pravrilgreen/iphone-hid/docs/README.md

# Documentation

## Guides

| Document | For |
|---|---|
| [Install a box](guide/install.md) | Parts, wiring, the board image and its HDMI input, installing, `ihcd doctor`, troubleshooting |
| [iPhone setup](guide/iphone-setup.md) | One-time settings on each iPhone |
| [Hardware check](guide/hardware-check.md) | Every touch and button tried on the real phone |

## Development

| Document | For |
|---|---|
| [API](dev/api.md) | REST actions, screen stream and live control protocols, Python SDK |
| [Architecture](dev/architecture.md) | Touch engine, USB gadget, video, server, doctor, simulated iPhone |
| [ADR 0001: languages](dev/adr/0001-languages.md) | Languages across the product |
| [ADR 0002: the box in Go](dev/adr/0002-box-in-go.md) | Why the box software is one Go binary |

## Research

| Document | For |
|---|---|
| [Absolute pointer on iPhone](research/absolute-pointer.md) | How iOS handles an absolute pointer over USB |
| [Custom box design](research/custom-box.md) | The purpose-built box: feasibility, chips, latency, cost, plan, shopping list |
| [Box v1 schematic](../hardware/box-v1/README.md) | Pin-level circuit of the purpose-built box, KiCad project, draft layout and BOM |
| [Ordering box v1](../hardware/box-v1/ORDERING.md) | What to send a layout and assembly house to have the box made |
| [Market survey](research/china-market.md) | How iPhone-control hardware on the market works |
