pravrilgreen/iphone-hid/hardware/box-v1/bom.csv

reference | qty | value | manufacturer | mpn | lcsc | lcsc_confidence | lcsc_evidence | jlc_type | assembly | dnp | unit_price_usd_est | price_basis | footprint | confidence | notes
C101 | 1 | 47uF 35V | KNSCHA | RVT47UF35V67RV0039 | C2836440 | Likely | search excerpt 2026-09-26 | Extended (assumed) | SMT | no | 0.0190 | search excerpt 2026-09-26 | Capacitor_SMD:CP_Elec_6.3x7.7 | Confirmed | VIN bulk capacitor, damps ringing when a long cable is hot-plugged; aluminium electrolytic 47 µF 35 V ±20 %, 6.3x7.7 mm
C102 C404 | 2 | 1uF 50V | Samsung Electro-Mechanics | CL10A105KB8NNNC | C15849 | Likely | JLCPCB parts list snapshot 2026-04-02 | Basic | SMT | no | 0.0110 | JLCPCB parts list snapshot 2026-04-02 | Capacitor_SMD:C_0603_1608Metric | Confirmed | CH224K VDD capacitor; PC-side VBUS capacitor (UFP ≤ 10 µF); 50 V X5R 0603
C103 C104 C111 C112 | 4 | 10uF 50V X7R | Samsung Electro-Mechanics | CL31B106KBHNNNE | C89632 | Likely | search excerpt 2026-09-26 | Extended (assumed) | SMT | no | 0.0556 | search excerpt 2026-09-26 | Capacitor_SMD:C_1206_3216Metric | Confirmed | U102 input capacitor; U103 input capacitor; 50 V X7R 1206 (price: LCSC 100+ break)
C105 C113 | 2 | 100nF 50V | YAGEO | CC0603KRX7R9BB104 | C14663 | Likely | JLCPCB parts list snapshot 2026-04-02 | Basic | SMT | no | 0.0060 | JLCPCB parts list snapshot 2026-04-02 | Capacitor_SMD:C_0603_1608Metric | Confirmed | High-frequency capacitor at the U102 VIN/GND pins; High-frequency capacitor at the U103 VIN/GND pins; 50 V X7R 0603
C106 C114 C309 | 3 | 1uF 25V | Samsung Electro-Mechanics | CL05A105KA5NQNC | C52923 | Likely | JLCPCB parts list snapshot 2026-04-02 | Basic | SMT | no | 0.0070 | JLCPCB parts list snapshot 2026-04-02 | Capacitor_SMD:C_0402_1005Metric | Confirmed | U102 internal LDO capacitor; U103 internal LDO capacitor; Extra VDDA capacitor for the ADC; 25 V X5R 0402
C107 C115 C120 C124 C125 C129 C203 C204 C205 C206 C207 C208 C209 C210 C211 C215 C218 C303 C304 C305 C306 C307 C308 C311 C402 C403 C405 | 27 | 100nF 16V / 100nF | Samsung Electro-Mechanics | CL05B104KO5NNNC | C1525 | Likely | JLCPCB parts list snapshot 2026-04-02 | Basic | SMT | no | 0.0050 | JLCPCB parts list snapshot 2026-04-02 | Capacitor_SMD:C_0402_1005Metric | Confirmed | U102 bootstrap capacitor; U103 bootstrap capacitor; U104 high-frequency input capacitor; U105 high-frequency input capacitor; …; 16 V X7R 0402
C108 C109 C110 C116 C117 C118 | 6 | 22uF 25V X5R | Samsung Electro-Mechanics | CL31A226KAHNNNE | C12891 | Likely | JLCPCB parts list snapshot 2026-04-02 | Basic | SMT | no | 0.0560 | JLCPCB parts list snapshot 2026-04-02 | Capacitor_SMD:C_1206_3216Metric | Confirmed | U102 output capacitor; U103 output capacitor; 25 V X5R 1206
C119 C123 C212 C213 C214 C310 | 6 | 10uF 10V | Samsung Electro-Mechanics | CL10A106KP8NNNC | C19702 | Likely | JLCPCB parts list snapshot 2026-04-02 | Basic | SMT | no | 0.0110 | JLCPCB parts list snapshot 2026-04-02 | Capacitor_SMD:C_0603_1608Metric | Confirmed | U104 input capacitor; U105 input capacitor; 1V2 bulk capacitor at the LT7911D; 1V2_LT_A bulk capacitor; 3V3_LT bulk capacitor; 3V3 bulk capacitor at the MCU; 10 V X5R 0603
C121 C122 C126 C127 C401 | 5 | 22uF 25V X5R | Samsung Electro-Mechanics | CL21A226MAQNNNE | C45783 | Likely | JLCPCB parts list snapshot 2026-04-02 | Basic | SMT | no | 0.0330 | JLCPCB parts list snapshot 2026-04-02 | Capacitor_SMD:C_0805_2012Metric | Confirmed | U104 output capacitor; U105 output capacitor; VCC5V0_SYS bulk capacitor next to the module; 25 V X5R 0805
C128 | 1 | 47nF 50V | Samsung Electro-Mechanics | CL10B473KB8NNNC | C1622 | Likely | JLCPCB parts list snapshot 2026-04-02 | Basic | SMT | no | 0.0080 | JLCPCB parts list snapshot 2026-04-02 | Capacitor_SMD:C_0603_1608Metric | Confirmed | Soft start (~0.5 ms), limits the charging current into the iPhone; 50 V X7R 0603
C130 C312 C313 | 3 | 1nF | FH (Guangdong Fenghua) | 0402B102K500NT | C1523 | Likely | JLCPCB parts list snapshot 2026-04-02 | Basic | SMT | no | 0.0050 | JLCPCB parts list snapshot 2026-04-02 | Capacitor_SMD:C_0402_1005Metric | Confirmed | U106 output filter before the ADC; CC1 ADC filter; CC2 ADC filter; 50 V X7R 0402
C201 C202 | 2 | 18pF C0G | FH (Guangdong Fenghua) | 0402CG180J500NT | C1549 | Likely | JLCPCB parts list snapshot 2026-04-02 | Basic | SMT | no | 0.0040 | JLCPCB parts list snapshot 2026-04-02 | Capacitor_SMD:C_0402_1005Metric | Unknown | [Unknown] Crystal load capacitor (unclear, per the Lontium reference design); Crystal load capacitor; 50 V C0G ±5 % 0402
C216 C217 | 2 | 100nF | Samsung Electro-Mechanics | CL05B104KO5NNNC | C1525 | Likely | JLCPCB parts list snapshot 2026-04-02 | Basic | SMT | no | 0.0050 | JLCPCB parts list snapshot 2026-04-02 | Capacitor_SMD:C_0402_1005Metric | Unknown | [Unknown] AUX AC capacitor (direction/bias unclear, per the Lontium reference design); AUX AC capacitor; 16 V X7R 0402
C219 | 1 | 10uF 25V | Samsung Electro-Mechanics | CL21A106KAYNNNE | C15850 | Likely | JLCPCB parts list snapshot 2026-04-02 | Basic | SMT | no | 0.0230 | JLCPCB parts list snapshot 2026-04-02 | Capacitor_SMD:C_0805_2012Metric | Confirmed | iPhone-side VBUS capacitor (Type-C source ≤ 120 µF); 25 V X5R 0805
C220 | 1 | 100nF 50V | Samsung Electro-Mechanics | CL05B104KB54PNC | C307331 | Likely | JLCPCB parts list snapshot 2026-04-02 | Basic | SMT | no | 0.0070 | JLCPCB parts list snapshot 2026-04-02 | Capacitor_SMD:C_0402_1005Metric | Confirmed | iPhone VBUS high-frequency capacitor; 50 V X7R 0402
C301 C302 | 2 | 18pF C0G | FH (Guangdong Fenghua) | 0402CG180J500NT | C1549 | Likely | JLCPCB parts list snapshot 2026-04-02 | Basic | SMT | no | 0.0040 | JLCPCB parts list snapshot 2026-04-02 | Capacitor_SMD:C_0402_1005Metric | Confirmed | HSE load capacitor: 2 x (12 pF - ~3 pF stray); HSE load capacitor; 50 V C0G ±5 % 0402
C314 C406 C407 C409 | 4 | 10nF / 10nF 50V | Samsung Electro-Mechanics | CL05B103KB5NNNC | C15195 | Likely | JLCPCB parts list snapshot 2026-04-02 | Basic | SMT | no | 0.0050 | JLCPCB parts list snapshot 2026-04-02 | Capacitor_SMD:C_0402_1005Metric | Confirmed | VBUS ADC filter; TX centre-tap capacitor (voltage-mode PHY); RX centre-tap capacitor; VIN ADC filter; 50 V X7R 0402
C408 | 1 | 1nF 2kV X7R | FH (Guangdong Fenghua) | 1206B102K202NT | C9196 | Likely | JLCPCB parts list snapshot 2026-04-02 | Basic | SMT | no | 0.0120 | JLCPCB parts list snapshot 2026-04-02 | Capacitor_SMD:C_1206_3216Metric | Confirmed | Bob-Smith node capacitor (2 kV keeps the 1500 V isolation of the magnetics); 2 kV X7R 1206
C410 | 1 | 1nF C0G | Murata | GRM1555C1H102JA01D | C76947 | Likely | search excerpt 2026-09-26 | Extended (assumed) | SMT | no | 0.0100 | allowance (no price found) | Capacitor_SMD:C_0402_1005Metric | Confirmed | RECOVERY key filter; 50 V C0G 0402
D101 | 1 | SMBJ20A | hongjiacheng | SMBJ20A | C19077575 | Likely | JLCPCB parts list snapshot 2026-04-02 | Preferred | SMT | no | 0.0350 | JLCPCB parts list snapshot 2026-04-02 | Diode_SMD:D_SMB | Confirmed | TVS on VIN: 20 V standoff, 32.4 V clamp, below the 36 V input rating of the LMR33630; 600 W TVS, 20 V standoff, 32.4 V clamp at 18.5 A, SMB
D102 | 1 | BZT52C10 | Diodes Incorporated | BZT52C10-7-F | C155227 | Likely | search excerpt 2026-09-26 | Extended (assumed) | SMT | no | 0.0200 | allowance (no price found) | Diode_SMD:D_SOD-123 | Confirmed | 10 V zener clamping Vgs in Option B (VIN up to 20 V); 10 V 500 mW zener SOD-123
D104 | 1 | SS34 | MDD (Microdiode Electronics) | SS34 | C8678 | Likely | JLCPCB parts list snapshot 2026-04-02 | Basic | SMT | no | 0.0310 | JLCPCB parts list snapshot 2026-04-02 | Diode_SMD:D_SMA | Confirmed | 3 A 40 V Schottky: PC_VBUS -> 5V_SYS (development mode); 3 A 40 V Schottky SMA
D201 D401 | 2 | SMF6.0A | Littelfuse | SMF6.0A | C207260 | Likely | search excerpt 2026-09-26 | Extended (assumed) | SMT | no | 0.0500 | allowance (no price found) | Diode_SMD:D_SOD-123F | Confirmed | iPhone VBUS TVS (Option B with VIN up to 20 V: change to SMF22A); PC VBUS TVS; 200 W unidirectional TVS, 6 V standoff, SOD-123FL
D501 | 1 | RED | Hubei KENTO Elec | KT-0603R | C2286 | Likely | JLCPCB parts list snapshot 2026-04-02 | Basic | SMT | no | 0.0090 | JLCPCB parts list snapshot 2026-04-02 | LED_SMD:LED_0603_1608Metric | Confirmed | RED status LED (red: no iPhone, yellow: HID but no video, green: ready); red 615-630 nm, Vf 1.8-2.4 V @ 20 mA
D502 | 1 | YELLOW | Foshan NationStar | NCD0603Y2 | C89811 | Likely | JLCPCB parts list snapshot 2026-04-02 | Preferred | SMT | no | 0.0210 | JLCPCB parts list snapshot 2026-04-02 | LED_SMD:LED_0603_1608Metric | Confirmed | YELLOW status LED (red: no iPhone, yellow: HID but no video, green: ready); yellow 586-595 nm, Vf 1.6-2.6 V
D503 | 1 | GREEN | Hubei KENTO Elec | KT-0603YG | C2289 | Likely | search excerpt 2026-09-26 | Extended (assumed) | SMT | no | 0.0059 | search excerpt 2026-09-26 | LED_SMD:LED_0603_1608Metric | Confirmed | GREEN status LED (red: no iPhone, yellow: HID but no video, green: ready); yellow-green (AlInGaP class) 0603; confirm Vf on the datasheet
F101 | 1 | 5A 32V | Littelfuse | 0466005.NRHF | C57525 | Likely | search excerpt 2026-09-26 | Extended (assumed) | SMT | no | 0.0326 | search excerpt 2026-09-26 | Fuse:Fuse_1206_3216Metric | Likely | [Likely] Very fast 5 A / 32 V input fuse; 466 series very fast acting 5 A 32 V 1206 (halogen-free version of 0466005.NR)
FB201 FB202 FB301 | 3 | 600R@100MHz | Murata | BLM18KG601SN1D | C85833 | Likely | search excerpt 2026-09-26 | Extended (assumed) | SMT | no | 0.0110 | search excerpt 2026-09-26 | Inductor_SMD:L_0603_1608Metric | Confirmed | Ferrite bead isolating the LT7911D 3.3 V; Ferrite bead isolating the 1.2 V analog/PLL supply; Ferrite isolating VDDA (VDDA = VIO at DC); 600 Ω @ 100 MHz, 1.3 A, 0.15 Ω, 0603
J101 J401 | 2 | USB-C PD IN / USB-C PC | Korean Hroparts Elec | TYPE-C-31-M-12 | C165948 | Likely | search excerpt 2026-09-26 | Extended (assumed) | SMT | no | 0.0960 | search excerpt 2026-09-26 | Connector_USB:USB_C_Receptacle_HRO_TYPE-C-31-M-12 | Confirmed | USB-C port that takes PD power from the charger (power + CC only); USB-C to the PC: the box is a USB device (UVC + USB network + control); USB-C 16P USB 2.0 receptacle, SMD, 5 A
J201 | 1 | USB-C iPhone | Korean Hroparts Elec | TYPE-C-31-M-04 | C129018 | Likely | search excerpt 2026-09-26 | Extended (assumed) | SMT | no | 0.3594 | search excerpt 2026-09-26 | box-v1:USB_C_Receptacle_HRO_TYPE-C-31-M-04 | Confirmed | 24-pin USB-C receptacle with all SS pairs (4-lane DP Alt Mode) + USB 2.0 + CC + VBUS; USB-C 24P USB 3.1 receptacle, hybrid (A row SMD, B row through-hole); replaces the Molex 105450-0101 of the first draft, whose all-SMD B row sits behind a keep-out and cannot be escaped without via-in-pad
J402 | 1 | RJ45 10/100 | HANRUN (Zhongshan HanRun Elec) | HR911105A | C12074 | Likely | search excerpt 2026-09-26 | Extended (assumed) | THT (hand or selective solder) | no | 0.9082 | search excerpt 2026-09-26 | Connector_RJ:RJ45_Hanrun_HR911105A_Horizontal | Confirmed | RJ45 with magnetics (magjack) 10/100; RJ45 with 10/100 magnetics and LEDs, through-hole
J501 | 1 | MCU SWD+UART | Würth Elektronik | 61300711121 |  |  |  | Extended (assumed) | THT (hand or selective solder) | no | 0.1000 | allowance (no price found) | Connector_PinHeader_2.54mm:PinHeader_1x07_P2.54mm_Vertical | Confirmed | WCH-LinkE header for the CH32V305 (2-wire SWD + debug UART); WR-PHD 2.54 mm 1x7 straight; any 2.54 mm 1x7 header fits; LCSC code: choose at order
J502 J503 | 2 | MCU USB FS / SoC UART | Würth Elektronik | 61300311121 |  |  |  | Extended (assumed) | THT (hand or selective solder) | no | 0.0500 | allowance (no price found) | Connector_PinHeader_2.54mm:PinHeader_1x03_P2.54mm_Vertical | Confirmed | Second (Full-Speed) USB of the CH32V305 (ISP over USB, experiments); RV1106 console (UART2_M1, 115200 8N1, 3.3 V); WR-PHD 2.54 mm 1x3 straight; any 2.54 mm 1x3 header fits; LCSC code: choose at order
L101 L102 | 2 | 10uH | Bourns | SRP1038A-100M | C780184 | Likely | search excerpt 2026-09-26 | Extended (assumed) | SMT | no | 0.4360 | search excerpt 2026-09-26 | Inductor_SMD:L_Bourns_SRP1038C_10.0x10.0mm | Likely | [Likely] U102 buck inductor, Isat ≥ 5 A; U103 buck inductor, Isat ≥ 4 A; 10 µH shielded, rated 7.5 A per LCSC excerpt; replaces SRP1038C-100M, which Bourns has moved to end of life; alternative SRP1038CC-100M; check the land pattern against the SRP1038C footprint
L103 L104 | 2 | 2.2uH | Bourns | SRN4018-2R2M | C913207 | Likely | search excerpt 2026-09-26 | Extended (assumed) | SMT | no | 0.1445 | search excerpt 2026-09-26 | Inductor_SMD:L_Bourns-SRN4018 | Likely | [Likely] U104 inductor, Isat ≥ 3 A, 4x4 mm; U105 inductor, Isat ≥ 3 A, 4x4 mm; 2.2 µH semi-shielded 4x4x1.8 mm, rated 2.9 A, 44 mΩ max per LCSC excerpt
Q101 Q102 | 2 | AO4407A | Alpha & Omega Semiconductor | AO4407A | C16072 | Likely | search excerpt 2026-09-26 | Extended (assumed) | SMT | no | 0.1070 | search excerpt 2026-09-26 | Package_SO:SOIC-8_3.9x4.9mm_P1.27mm | Likely | [Likely] Source-side P-MOSFET (back-to-back): -30 V, ~11 mΩ @ -10 V; iPhone-side P-MOSFET (back-to-back): -30 V, ~11 mΩ @ -10 V; P-MOSFET -30 V; RDS(on) < 13 mΩ @ -10 V, about 18 mΩ @ -4.5 V per datasheet excerpt
Q103 | 1 | 2N7002 | Changjiang Electronics Tech (CJ) | 2N7002 | C8545 | Likely | JLCPCB parts list snapshot 2026-04-02 | Basic | SMT | no | 0.0180 | JLCPCB parts list snapshot 2026-04-02 | Package_TO_SOT_SMD:SOT-23 | Confirmed | N-MOSFET pulling the gate down
R101 | 1 | 1k | UNI-ROYAL (Uniroyal Elec) | 1206W4F1001T5E | C4410 | Likely | JLCPCB parts list snapshot 2026-04-02 | Basic | SMT | no | 0.0070 | JLCPCB parts list snapshot 2026-04-02 | Resistor_SMD:R_1206_3216Metric | Confirmed | CH224K VDD feed resistor (datasheet §6.2); thick film 1 % 250 mW 1206
R103 | 1 | 6.8k 1% | UNI-ROYAL (Uniroyal Elec) | 0402WGF6801TCE | C25917 | Likely | JLCPCB parts list snapshot 2026-04-02 | Preferred | SMT | no | 0.0040 | JLCPCB parts list snapshot 2026-04-02 | Resistor_SMD:R_0402_1005Metric | Confirmed | Requested voltage: 6.8k=9V (default), 24k=12V, 56k=15V, open=20V; thick film 1 % 62.5 mW 0402
R104 R105 R127 R405 R406 R407 R408 | 7 | 0R | UNI-ROYAL (Uniroyal Elec) | 0402WGF0000TCE | C17168 | Likely | JLCPCB parts list snapshot 2026-04-02 | Basic | SMT | no | 0.0040 | JLCPCB parts list snapshot 2026-04-02 | Resistor_SMD:R_0402_1005Metric | Confirmed | Option A: charger CC to the CH224K; Option A: the CH32V305 switches the iPhone VBUS; 0R as in the Luckfox design: room for a filter/ESD part; thick film 1 % 62.5 mW 0402
R108 R124 R203 R302 R303 R403 R411 | 7 | 10k | UNI-ROYAL (Uniroyal Elec) | 0402WGF1002TCE | C25744 | Likely | JLCPCB parts list snapshot 2026-04-02 | Basic | SMT | no | 0.0050 | JLCPCB parts list snapshot 2026-04-02 | Resistor_SMD:R_0402_1005Metric | Confirmed | Pull-up for PG (open drain) to MCU PB12; Gate resistor: Vgs = -Vin x 100k/110k; RST_N pull-up: the LT7911D runs as soon as it is powered; …; thick film 1 % 62.5 mW 0402
R109 R111 R113 R115 R117 R118 R120 R121 R122 R123 R125 R205 R304 R305 R306 R409 | 16 | 100k 1% / 100k | UNI-ROYAL (Uniroyal Elec) | 0402WGF1003TCE | C25741 | Likely | JLCPCB parts list snapshot 2026-04-02 | Basic | SMT | no | 0.0040 | JLCPCB parts list snapshot 2026-04-02 | Resistor_SMD:R_0402_1005Metric | Confirmed | U102 upper feedback resistor; U102 EN divider (top); U103 upper feedback resistor; U103 EN divider (top); U104 EN: on as soon as 5V_SYS is present; …; thick film 1 % 62.5 mW 0402
R110 | 1 | 23.7k 1% | YAGEO | RC0402FR-0723K7L | C327362 | Likely | search excerpt 2026-09-26 | Extended (assumed) | SMT | no | 0.0100 | allowance (no price found) | Resistor_SMD:R_0402_1005Metric | Confirmed | U102 lower feedback resistor: Vout = 1.0 V x (1 + 100k/Rfbb); thick film 1 % 0402
R112 | 1 | 20k | UNI-ROYAL (Uniroyal Elec) | 0402WGF2002TCE | C25765 | Likely | JLCPCB parts list snapshot 2026-04-02 | Basic | SMT | no | 0.0040 | JLCPCB parts list snapshot 2026-04-02 | Resistor_SMD:R_0402_1005Metric | Confirmed | U102 EN divider (bottom); thick film 1 % 62.5 mW 0402
R114 | 1 | 24.9k 1% | YAGEO | RC0402FR-0724K9L |  |  |  | Extended (assumed) | SMT | no | 0.0100 | allowance (no price found) | Resistor_SMD:R_0402_1005Metric | Confirmed | U103 lower feedback resistor: Vout = 1.0 V x (1 + 100k/Rfbb); thick film 1 % 0402; UNI-ROYAL 0402WGF2492TCE is equivalent; LCSC code: choose at order
R116 | 1 | 39k | UNI-ROYAL (Uniroyal Elec) | 0402WGF3902TCE | C25783 | Likely | JLCPCB parts list snapshot 2026-04-02 | Preferred | SMT | no | 0.0040 | JLCPCB parts list snapshot 2026-04-02 | Resistor_SMD:R_0402_1005Metric | Confirmed | U103 EN divider (bottom); thick film 1 % 62.5 mW 0402
R119 | 1 | 22.1k 1% | YAGEO | RC0402FR-0722K1L |  |  |  | Extended (assumed) | SMT | no | 0.0100 | allowance (no price found) | Resistor_SMD:R_0402_1005Metric | Confirmed | U104 lower feedback resistor: Vout = 0.6 V x (1 + 100k/Rbot); thick film 1 % 0402; UNI-ROYAL 0402WGF2212TCE is equivalent; LCSC code: choose at order
R126 | 1 | 10m 1% | YAGEO | RL1206FR-7W0R01L | C155193 | Likely | search excerpt 2026-09-26 | Extended (assumed) | SMT | no | 0.0191 | search excerpt 2026-09-26 | Resistor_SMD:R_1206_3216Metric | Confirmed | iPhone charging current shunt (Kelvin); current sense 10 mΩ 1 % 0.5 W 1206
R201 R202 | 2 | 2.2k | UNI-ROYAL (Uniroyal Elec) | 0402WGF2201TCE | C25879 | Likely | JLCPCB parts list snapshot 2026-04-02 | Basic | SMT | no | 0.0040 | JLCPCB parts list snapshot 2026-04-02 | Resistor_SMD:R_0402_1005Metric | Confirmed | I2C pull-up to the module's 3.3 V (the RV1106 IO domain), so the bus never feeds an unpowered SoC; I2C pull-up (as R201); thick film 1 % 62.5 mW 0402
R210 | 1 | 10k | UNI-ROYAL (Uniroyal Elec) | 0603WAF1002T5E | C25804 | Likely | JLCPCB parts list snapshot 2026-04-02 | Basic | SMT | no | 0.0050 | JLCPCB parts list snapshot 2026-04-02 | Resistor_SMD:R_0603_1608Metric | Confirmed | Discharges VBUS to vSafe0V (< 0.8 V in ~0.4 s); thick film 1 % 100 mW 0603
R213 R413 | 2 | 1k | UNI-ROYAL (Uniroyal Elec) | 0402WGF1001TCE | C11702 | Likely | JLCPCB parts list snapshot 2026-04-02 | Basic | SMT | no | 0.0040 | JLCPCB parts list snapshot 2026-04-02 | Resistor_SMD:R_0402_1005Metric | Confirmed | Series resistor: the RV1106 GPIO no longer discharges C215 directly; Limits the current when the RV1106 and a WCH-LinkE both drive NRST; thick film 1 % 62.5 mW 0402
R301 | 1 | 4.7k | UNI-ROYAL (Uniroyal Elec) | 0402WGF4701TCE | C25900 | Likely | JLCPCB parts list snapshot 2026-04-02 | Basic | SMT | no | 0.0040 | JLCPCB parts list snapshot 2026-04-02 | Resistor_SMD:R_0402_1005Metric | Confirmed | NRST pull-up, strong enough to win over the default pull-down of GPIO1_D3 (RV1106) through R413; thick film 1 % 62.5 mW 0402
R307 | 1 | 15k | UNI-ROYAL (Uniroyal Elec) | 0402WGF1502TCE | C25756 | Likely | JLCPCB parts list snapshot 2026-04-02 | Basic | SMT | no | 0.0040 | JLCPCB parts list snapshot 2026-04-02 | Resistor_SMD:R_0402_1005Metric | Confirmed | iPhone VBUS divider; thick film 1 % 62.5 mW 0402
R401 R402 | 2 | 5.1k 1% | UNI-ROYAL (Uniroyal Elec) | 0402WGF5101TCE | C25905 | Likely | JLCPCB parts list snapshot 2026-04-02 | Basic | SMT | no | 0.0040 | JLCPCB parts list snapshot 2026-04-02 | Resistor_SMD:R_0402_1005Metric | Confirmed | Rd: the box is the UFP (sink) towards the PC; Rd; thick film 1 % 62.5 mW 0402
R404 | 1 | 18k | UNI-ROYAL (Uniroyal Elec) | 0402WGF1802TCE | C25762 | Likely | JLCPCB parts list snapshot 2026-04-02 | Preferred | SMT | no | 0.0040 | JLCPCB parts list snapshot 2026-04-02 | Resistor_SMD:R_0402_1005Metric | Confirmed | VBUSDET divider; thick film 1 % 62.5 mW 0402
R410 | 1 | 8.2k 1% | UNI-ROYAL (Uniroyal Elec) | 0402WGF8201TCE | C25924 | Likely | JLCPCB parts list snapshot 2026-04-02 | Preferred | SMT | no | 0.0040 | JLCPCB parts list snapshot 2026-04-02 | Resistor_SMD:R_0402_1005Metric | Confirmed | VIN divider; thick film 1 % 62.5 mW 0402
R412 | 1 | 100R | UNI-ROYAL (Uniroyal Elec) | 0402WGF1000TCE | C25076 | Likely | JLCPCB parts list snapshot 2026-04-02 | Basic | SMT | no | 0.0040 | JLCPCB parts list snapshot 2026-04-02 | Resistor_SMD:R_0402_1005Metric | Confirmed | RECOVERY key series resistor; thick film 1 % 62.5 mW 0402
R501 R502 | 2 | 680R | UNI-ROYAL (Uniroyal Elec) | 0402WGF6800TCE | C25130 | Likely | JLCPCB parts list snapshot 2026-04-02 | Preferred | SMT | no | 0.0040 | JLCPCB parts list snapshot 2026-04-02 | Resistor_SMD:R_0402_1005Metric | Confirmed | RED LED current limit ~2 mA; YELLOW LED current limit ~2 mA; thick film 1 % 62.5 mW 0402
R503 | 1 | 560R | YAGEO | RC0402FR-07560RL |  |  |  | Extended (assumed) | SMT | no | 0.0100 | allowance (no price found) | Resistor_SMD:R_0402_1005Metric | Confirmed | GREEN LED current limit ~2 mA; thick film 1 % 0402; UNI-ROYAL 0402WGF5600TCE is equivalent; LCSC code: choose at order
SW501 SW502 | 2 | RECOVERY / RESET | XKB Connection | TS-1187A-B-A-B | C318884 | Likely | JLCPCB parts list snapshot 2026-04-02 | Basic | SMT | no | 0.0250 | JLCPCB parts list snapshot 2026-04-02 | Button_Switch_SMD:SW_Push_1P1T_XKB_TS-1187A | Confirmed | Hold at power-up: the RV1106 enters loader mode (rockusb) over the PC USB-C; RV1106 reset (NPOR); SMD tactile 5.1 x 5.1 mm, 1.5 mm actuator, 160 gf; smaller and cheaper than the TL3342 of the first draft
U101 | 1 | CH224K | WCH (Jiangsu Qin Heng) | CH224K | C970725 | Likely | search excerpt 2026-09-26 | Extended (assumed) | SMT | no | 0.3300 | search excerpt 2026-09-26 | Package_SO:SSOP-10-1EP_3.9x4.9mm_P1mm_EP2.1x3.3mm | Confirmed | PD trigger (sink) for the power input
U102 U103 | 2 | LMR33630ADDA | Texas Instruments | LMR33630ADDAR | C841384 | Likely | search excerpt 2026-09-26 | Extended (assumed) | SMT | no | 0.5163 | search excerpt 2026-09-26 | Package_SO:Texas_HSOP-8-1EP_3.9x4.9mm_P1.27mm_ThermalVias | Likely | [Likely] Buck VIN -> 5V2_PHONE (5.22 V / 3 A) for the iPhone; starts when VIN > ~7.2 V; Buck VIN -> 5V_SYS (5.02 V / 3 A) for the Core1106 and the rails; …
U104 U105 | 2 | TLV62569DBV | Texas Instruments | TLV62569DBVR | C141836 | Likely | search excerpt 2026-09-26 | Extended (assumed) | SMT | no | 0.2500 | allowance (no price found) | Package_TO_SOT_SMD:SOT-23-5 | Likely | [Likely] Buck 5V_SYS -> 3V3 (3.315 V / 2 A); Buck 5V_SYS -> 1V2 (1.2 V / 2 A) for the LT7911D, after 3V3; the search excerpt showed $0.0424, which looks implausibly low; allowance used
U106 | 1 | INA180A2 | Texas Instruments | INA180A2IDBVR | C192764 | Likely | search excerpt 2026-09-26 | Extended (assumed) | SMT | no | 0.1065 | search excerpt 2026-09-26 | Package_TO_SOT_SMD:SOT-23-5 | Likely | [Likely] Shunt current amplifier, gain 50: 3 A -> 1.5 V
U107 U202 U203 U204 | 4 | TPD4E05U06DQA | Texas Instruments | TPD4E05U06DQAR | C138714 | Likely | search excerpt 2026-09-26 | Extended (assumed) | SMT | no | 0.0361 | search excerpt 2026-09-26 | Package_SON:USON-10_2.5x1.0mm_P0.5mm | Confirmed | ESD for the CC lines of J101 (charger) and J401 (PC), between the two rear ports (flow-through); ESD for SS pairs TX1/RX1 (0.5 pF, flow-through); …
U201 | 1 | LT7911D | Lontium Semiconductor | LT7911D | C5310990 | Likely | search excerpt 2026-09-26 | Extended (assumed) | SMT | no | 4.9000 | search excerpt 2026-09-26 | box-v1:LT7911D_QFN-64-1EP_7.5x7.5mm_P0.4mm | Likely | [Likely] Type-C/DP1.2 -> MIPI CSI-2, PD + DP Alt Mode sink, on-chip MCU + flash; price from a Global Sources excerpt ($4.9, chip only); firmware for CSI output and the full datasheet come from Lontium or its distributor
U205 U402 | 2 | USBLC6-2SC6 | STMicroelectronics | USBLC6-2SC6 | C7519 | Likely | search excerpt 2026-09-26 | Extended (assumed) | SMT | no | 0.0896 | search excerpt 2026-09-26 | Package_TO_SOT_SMD:SOT-23-6 | Confirmed | ESD for the iPhone USB 2.0 pair; ESD for the PC-side USB 2.0
U301 | 1 | CH32V305RBT6 | WCH (Jiangsu Qin Heng) | CH32V305RBT6 | C5187529 | Likely | search excerpt 2026-09-26 | Extended (assumed) | SMT | no | 1.3334 | search excerpt 2026-09-26 | Package_QFP:LQFP-64_10x10mm_P0.5mm | Confirmed | RISC-V MCU: USB HS (internal PHY) as HID for the iPhone, SPI/UART link to the RV1106
U401 | 1 | Luckfox Core1106 | Luckfox | Core1106 (RV1106G3, 256 MB, 8 GB eMMC, Wi-Fi 6/BT 5.2 variant) |  |  |  | n/a | module (castellated, consigned) | no | 27.0000 | search excerpt 2026-09-26 | box-v1:Luckfox_Core1106_Castellated_30x30mm_P1.0mm | Likely | [Likely] RV1106G3 SoC module: 4-lane CSI-2, H.264, 100M Ethernet PHY, USB 2.0 OTG, on-module Wi-Fi; not stocked by LCSC: buy from Luckfox or Waveshare and consign; Waveshare lists the variants as Core11060208 / Core11060408 / Core11061208 / Core11061408 (which code is G3 + eMMC + Wi-Fi was not verified here: check the store page); price is the top of the $16.34-26.99 range seen in search excerpts; LCSC code: choose at order
X201 | 1 | 25MHz | YXC (Yangxing Tech) | X322525MOB4SI | C9006 | Likely | JLCPCB parts list snapshot 2026-04-02 | Basic | SMT | no | 0.0740 | JLCPCB parts list snapshot 2026-04-02 | Crystal:Crystal_SMD_3225-4Pin_3.2x2.5mm | Unknown | [Unknown] LT7911D crystal (frequency and load unknown); 25 MHz 12 pF ±10 ppm SMD3225-4P; placeholder until Lontium gives the crystal spec
X301 | 1 | 8MHz | YXC (Yangxing Tech) | X32258MOB4SI | C2682775 | Likely | search excerpt 2026-09-26 | Extended (assumed) | SMT | no | 0.0791 | search excerpt 2026-09-26 | Crystal:Crystal_SMD_3225-4Pin_3.2x2.5mm | Confirmed | 8 MHz HSE crystal, CL 12 pF, ±20 ppm; 8 MHz SMD3225-4P; 'MO' = 12 pF by analogy with X322525MOB4SI: confirm CL = 12 pF
JP101 | 1 | PSW_SRC | - | none (solder jumper on the PCB) |  |  |  | n/a | none (PCB copper) | no |  |  | Jumper:SolderJumper-3_P1.3mm_Bridged12_RoundedPad1.0x1.5mm | Confirmed | iPhone supply select: 1-2 = 5V2_PHONE (Option A, default), 2-3 = VIN (Option B)
JP102 | 1 | PC_PWR | - | none (solder jumper on the PCB) |  |  |  | n/a | none (PCB copper) | no |  |  | Jumper:SolderJumper-2_P1.3mm_Open_RoundedPad1.0x1.5mm | Confirmed | Open by default. Bridge it to power the box from the PC (only when NO charger is on J101)
TP201 TP202 TP401 TP501 TP502 TP503 TP504 TP505 TP506 TP507 TP508 TP509 TP510 | 13 | test pads | - | none (copper test pad) |  |  |  | n/a | none (PCB copper) | no |  |  | TestPoint:TestPoint_Pad_D1.5mm | Confirmed | Measure/force SLEEP_33; Measure RX_HPD; Checks that the module PMIC is up; Test point VIN; Test point 5V2_PHONE; Test point 5V_SYS; Test point 3V3; …
R106 R107 R128 | 3 | 0R | UNI-ROYAL (Uniroyal Elec) | 0402WGF0000TCE | C17168 | Likely | JLCPCB parts list snapshot 2026-04-02 | Basic | SMT | yes | 0.0040 | JLCPCB parts list snapshot 2026-04-02 | Resistor_SMD:R_0402_1005Metric | Unknown | DNP (not fitted) [Unknown] Option B: charger CC to the second PD port of the LT7911D; Option B (as R106); Option B: an LT7911D GPIO switches the iPhone VBUS; thick film 1 % 62.5 mW 0402
R204 | 1 | 10k | UNI-ROYAL (Uniroyal Elec) | 0402WGF1002TCE | C25744 | Likely | JLCPCB parts list snapshot 2026-04-02 | Basic | SMT | yes | 0.0050 | JLCPCB parts list snapshot 2026-04-02 | Resistor_SMD:R_0402_1005Metric | Unknown | DNP (not fitted) [Unknown] Optional level for SLEEP_33 (unclear); thick film 1 % 62.5 mW 0402
R206 R207 | 2 | 1M | UNI-ROYAL (Uniroyal Elec) | 0402WGF1004TCE | C26083 | Likely | JLCPCB parts list snapshot 2026-04-02 | Basic | SMT | yes | 0.0040 | JLCPCB parts list snapshot 2026-04-02 | Resistor_SMD:R_0402_1005Metric | Unknown | DNP (not fitted) [Unknown] Sink-side AUX bias (unclear); thick film 1 % 62.5 mW 0402
R211 R212 | 2 | 5.1k | UNI-ROYAL (Uniroyal Elec) | 0402WGF5101TCE | C25905 | Likely | JLCPCB parts list snapshot 2026-04-02 | Basic | SMT | yes | 0.0040 | JLCPCB parts list snapshot 2026-04-02 | Resistor_SMD:R_0402_1005Metric | Confirmed | DNP (not fitted) Temporary Rd for HID-only bring-up (LT7911D not fitted): the iPhone becomes source + host; Temporary Rd for HID-only bring-up; thick film 1 % 62.5 mW 0402
