pravrilgreen/iphone-hid/hardware/box-v1/kicad/box-v1.kicad_pcb

## KiCad design hardware/box-v1/kicad/box-v1.kicad_pcb (2026-09-26)

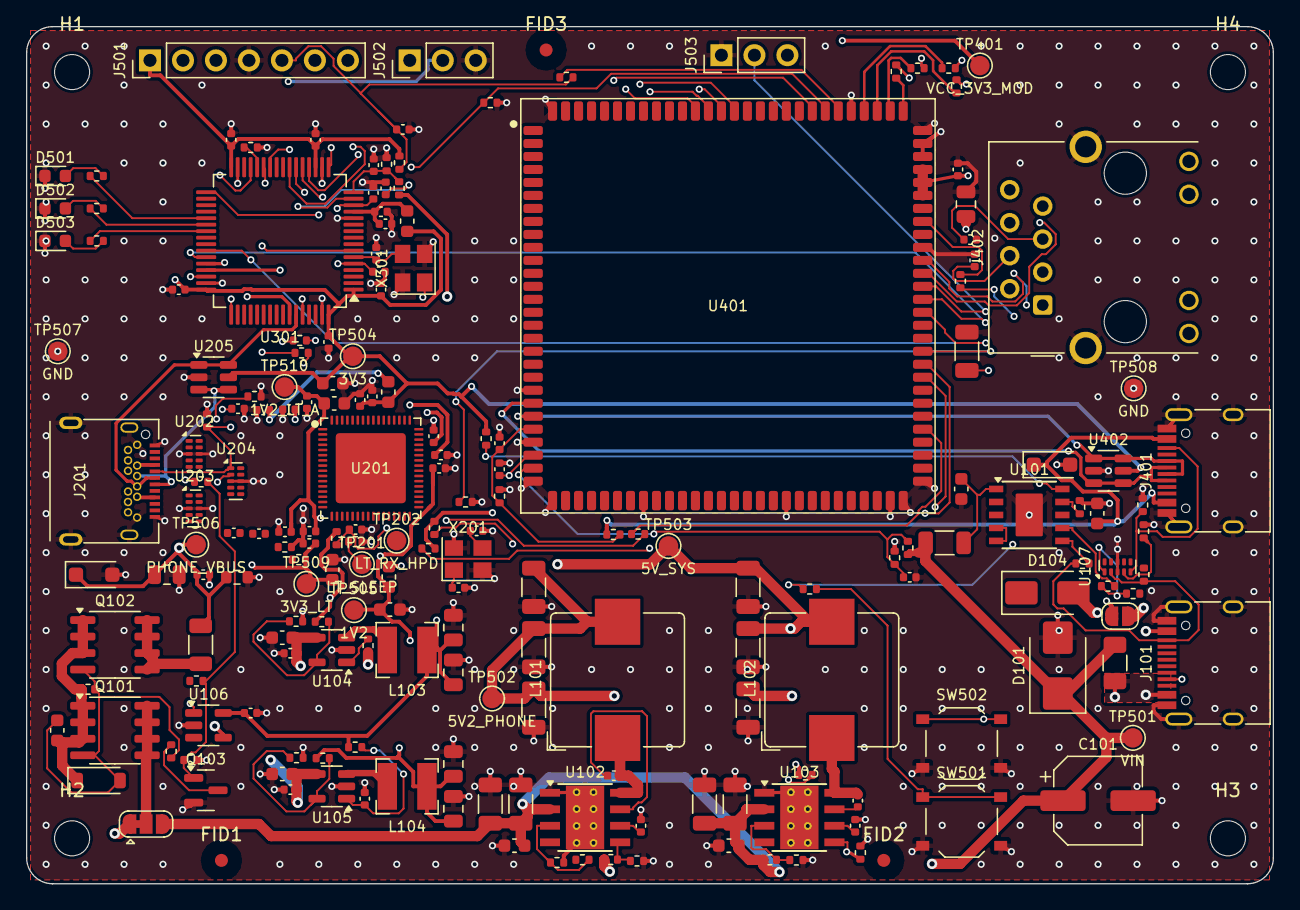
[picture p5: board box-v1.kicad_pcb from above]

Board: 4 copper layers, 96.0 x 66.0 mm, 202 parts (0 on the bottom side), 122 nets.

Parts:
C101: 47uF 35V; CP_Elec_6.3x7.7
C102, C404: 1uF 50V; C_0603_1608Metric
C103, C104, C111, C112: 10uF 50V X7R; C_1206_3216Metric
C105, C113: 100nF 50V; C_0603_1608Metric
C106, C114, C309: 1uF 25V; C_0402_1005Metric
C107, C115: 100nF 16V; C_0402_1005Metric
C108, C109, C110, C116, C117, C118: 22uF 25V X5R; C_1206_3216Metric
C119, C123, C212, C213, C214, C310: 10uF 10V; C_0603_1608Metric
C120, C124, C125, C129, C203, C204, C205, C206, C207, C208, C209, C210, C211, C215, C216, C217, C218, C303, C304, C305, C306, C307, C308, C311, C402, C403, C405: 100nF; C_0402_1005Metric
C121, C122, C126, C127, C401: 22uF 25V X5R; C_0805_2012Metric
C128: 47nF 50V; C_0603_1608Metric
C130, C312, C313: 1nF; C_0402_1005Metric
C201, C202, C301, C302: 18pF C0G; C_0402_1005Metric
C219: 10uF 25V; C_0805_2012Metric
C220: 100nF 50V; C_0402_1005Metric
C314, C409: 10nF; C_0402_1005Metric
C406, C407: 10nF 50V; C_0402_1005Metric
C408: 1nF 2kV X7R; C_1206_3216Metric
C410: 1nF C0G; C_0402_1005Metric
D101: SMBJ20A; D_SMB
D102: BZT52C10; D_SOD-123
D104: SS34; D_SMA
D201, D401: SMF6.0A; D_SOD-123F
D501: RED; LED_0603_1608Metric
D502: YELLOW; LED_0603_1608Metric
D503: GREEN; LED_0603_1608Metric
F101: 5A 32V; Fuse_1206_3216Metric
FB201, FB202, FB301: 600R@100MHz; L_0603_1608Metric
FID1, FID2, FID3: Fiducial_1mm_Mask2mm
H1, H2, H3, H4: M2.5; MountingHole_2.7mm_M2.5
J101: USB-C PD IN; USB_C_Receptacle_HRO_TYPE-C-31-M-12
J201: USB-C iPhone; USB_C_Receptacle_HRO_TYPE-C-31-M-04
J401: USB-C PC; USB_C_Receptacle_HRO_TYPE-C-31-M-12
J402: RJ45 10/100; RJ45_Hanrun_HR911105A_Horizontal
J501: MCU SWD+UART; PinHeader_1x07_P2.54mm_Vertical
J502: MCU USB FS; PinHeader_1x03_P2.54mm_Vertical
J503: SoC UART; PinHeader_1x03_P2.54mm_Vertical
JP101: PSW_SRC; SolderJumper-3_P1.3mm_Bridged12_RoundedPad1.0x1.5mm
JP102: PC_PWR; SolderJumper-2_P1.3mm_Open_RoundedPad1.0x1.5mm
L101, L102: 10uH; L_Bourns_SRP1038C_10.0x10.0mm
L103, L104: 2.2uH; L_Bourns-SRN4018
Q101, Q102: AO4407A; SOIC-8_3.9x4.9mm_P1.27mm
Q103: 2N7002; SOT-23
R101: 1k; R_1206_3216Metric
R103: 6.8k 1%; R_0402_1005Metric
R104, R105, R106, R107, R127, R128, R405, R406, R407, R408: 0R; R_0402_1005Metric
R108, R124, R203, R204, R302, R303, R403, R411: 10k; R_0402_1005Metric
R109, R113, R118, R121, R122, R409: 100k 1%; R_0402_1005Metric
R110: 23.7k 1%; R_0402_1005Metric
R111, R115, R117, R120, R123, R125, R205, R304, R305, R306: 100k; R_0402_1005Metric
R112: 20k; R_0402_1005Metric
R114: 24.9k 1%; R_0402_1005Metric
R116: 39k; R_0402_1005Metric
R119: 22.1k 1%; R_0402_1005Metric
R126: 10m 1%; R_1206_3216Metric
R201, R202: 2.2k; R_0402_1005Metric
R206, R207: 1M; R_0402_1005Metric
R210: 10k; R_0603_1608Metric
R211, R212: 5.1k; R_0402_1005Metric
R213, R413: 1k; R_0402_1005Metric
R301: 4.7k; R_0402_1005Metric
R307: 15k; R_0402_1005Metric
R401, R402: 5.1k 1%; R_0402_1005Metric
R404: 18k; R_0402_1005Metric
R410: 8.2k 1%; R_0402_1005Metric
R412: 100R; R_0402_1005Metric
R501, R502: 680R; R_0402_1005Metric
R503: 560R; R_0402_1005Metric
SW501: RECOVERY; SW_Push_1P1T_XKB_TS-1187A
SW502: RESET; SW_Push_1P1T_XKB_TS-1187A
TP201: LT_SLEEP; TestPoint_Pad_D1.5mm
TP202: LT_RX_HPD; TestPoint_Pad_D1.5mm
TP401: VCC_3V3_MOD; TestPoint_Pad_D1.5mm
TP501: VIN; TestPoint_Pad_D1.5mm
TP502: 5V2_PHONE; TestPoint_Pad_D1.5mm
TP503: 5V_SYS; TestPoint_Pad_D1.5mm
TP504: 3V3; TestPoint_Pad_D1.5mm
TP505: 1V2; TestPoint_Pad_D1.5mm
TP506: PHONE_VBUS; TestPoint_Pad_D1.5mm
TP507, TP508: GND; TestPoint_Pad_D1.5mm
TP509: 3V3_LT; TestPoint_Pad_D1.5mm
TP510: 1V2_LT_A; TestPoint_Pad_D1.5mm
U101: CH224K; SSOP-10-1EP_3.9x4.9mm_P1mm_EP2.1x3.3mm
U102, U103: LMR33630ADDA; Texas_HSOP-8-1EP_3.9x4.9mm_P1.27mm_ThermalVias
U104, U105: TLV62569DBV; SOT-23-5
U106: INA180A2; SOT-23-5
U107, U202, U203, U204: TPD4E05U06DQA; USON-10_2.5x1.0mm_P0.5mm
U201: LT7911D; LT7911D_QFN-64-1EP_7.5x7.5mm_P0.4mm
U205, U402: USBLC6-2SC6; SOT-23-6
U301: CH32V305RBT6; LQFP-64_10x10mm_P0.5mm
U401: Luckfox Core1106; Luckfox_Core1106_Castellated_30x30mm_P1.0mm
X201: 25MHz; Crystal_SMD_3225-4Pin_3.2x2.5mm
X301: 8MHz; Crystal_SMD_3225-4Pin_3.2x2.5mm

Connections:
1V2: C126.1, C127.1, C203.1, C209.1, C211.1, C212.1, FB202.1, L104.2, R121.1, TP505.1, U201.1
1V2_LT_A: C204.1, C206.1, C207.1, C213.1, FB202.2, TP510.1, U201.4, U201.10, U201.13
3V3: C121.1, C122.1, C129.1, C218.1, C303.1, C304.1, C305.1, C306.1, C307.1, C310.1, C403.1, FB201.1, FB301.1, J501.1, L103.2, R108.2, R118.1, R120.1, R203.2, R301.2, TP504.1, U106.5, U205.5, U301.1, U301.19, U301.32, U301.48, U301.64, U402.5
3V3_LT: C205.1, C208.1, C210.1, C214.1, FB201.2, R207.2, TP509.1, U201.7, U201.16
5V2_PHONE: C108.1, C109.1, C110.1, JP101.1, L101.2, R109.1, TP502.1
5V_SYS: C116.1, C117.1, C118.1, C119.1, C120.1, C123.1, C124.1, C401.1, C402.1, D104.1, L102.2, R113.1, R117.1, TP503.1, U104.4, U105.4, U401.79, U401.80, U401.81
CC1_SENSE: C312.1, R304.2, U301.14
CC2_SENSE: C313.1, R305.2, U301.15
CH224_CC1: R104.2, U101.7
CH224_CC2: R105.2, U101.6
CH224_CFG1: R103.1, U101.9
CH224_DPDM: U101.4, U101.5
CH224_VDD: C102.1, R101.2, U101.1
ETH_BS: C408.1, J402.8
ETH_RCT: C407.1, J402.5
ETH_RXN_J: J402.6, R408.2
ETH_RXP_J: J402.3, R407.2
ETH_RX_N: R408.1, U401.85
ETH_RX_P: R407.1, U401.86
ETH_TCT: C406.1, J402.4
ETH_TXN_J: J402.2, R406.2
ETH_TXP_J: J402.1, R405.2
ETH_TX_N: R406.1, U401.87
ETH_TX_P: R405.1, U401.88
GND: C101.2, C102.2, C103.2, C104.2, C105.2, C106.2, C108.2, C109.2, C110.2, C111.2, C112.2, C113.2, C114.2, C116.2, C117.2, C118.2, C119.2, C120.2, C121.2, C122.2, C123.2, C124.2, C125.2, C126.2, C127.2, C129.2, C130.2, C201.2, C202.2, C203.2, C204.2, C205.2, C206.2, C207.2, C208.2, C209.2, C210.2, C211.2, C212.2, C213.2, C214.2, C215.2, C218.2, C219.2, C220.2, C301.2, C302.2, C303.2, C304.2, C305.2, C306.2, C307.2, C308.2, C309.2, C310.2, C311.2, C312.2, C313.2, C314.2, C401.2, C402.2, C403.2, C404.2, C405.2, C406.2, C407.2, C408.2, C409.2, C410.2, D101.2, D201.2, D401.2, D501.1, D502.1, D503.1, J101.A1, J101.A12, J101.B1, J101.B12, J101.S1, J201.31, J201.32, J201.33, J201.34, J201.A1, J201.A12, J201.B1, J201.B12, J401.A1, J401.A12, J401.B1, J401.B12, J401.S1, J402.SH, J501.4, J502.3, J503.1, Q103.2, R103.2, R110.2, R112.2, R114.2, R116.2, R119.2, R122.2, R125.2, R204.2, R205.2, R206.2, R210.2, R211.2, R212.2, R302.2, R303.2, R307.2, R401.2, R402.2, R404.2, R410.2, SW501.2, SW502.2, TP507.1, TP508.1, U101.11, U102.1, U102.9, U103.1, U103.9, U104.2, U105.2, U106.2, U107.3, U107.8, U202.3, U202.8, U203.3, U203.8, U204.3, U204.8, U205.2, U301.12, U301.18, U301.31, U301.47, U301.63, U401.21, U401.25, U401.28, U401.29, U401.36, U401.47, U401.55, U401.56, U401.57, U401.75, U401.82, U401.83, U401.84, U401.89, U401.112, U402.2, X201.2, X201.4, X301.2, X301.4
HSE_IN: C301.1, U301.5, X301.1
HSE_OUT: C302.1, U301.6, X301.3
LED_G: R503.1, U301.39
LED_G_A: D503.2, R503.2
LED_R: R501.1, U301.37
LED_R_A: D501.2, R501.2
LED_Y: R502.1, U301.38
LED_Y_A: D502.2, R502.2
LT_AUX_N: C217.2, R207.1, U201.18
LT_AUX_P: C216.2, R206.1, U201.17
LT_INT: R205.1, U401.67
LT_RST_N: C215.1, R203.1, R213.2, U201.20
LT_RX_HPD: TP202.1, U201.23
LT_SCL: R201.1, U201.21, U401.65
LT_SDA: R202.1, U201.22, U401.66
LT_SLEEP: R204.1, TP201.1, U201.19
LT_XI: C201.1, X201.1
LT_XO: C202.1, X201.3
MCU_BOOT0: R302.1, U301.60, U401.91
MCU_BOOT1: R303.1, U301.28
MCU_DBG_RX: J501.7, U301.30
MCU_DBG_TX: J501.6, U301.29
MCU_FS_DN: J502.2, U301.44
MCU_FS_DP: J502.1, U301.45
MCU_IRQ: U301.26, U401.92
MCU_NRST: C311.1, J501.5, R301.1, R413.2, U301.7
MCU_UART_RX: U301.43, U401.71
MCU_UART_TX: U301.42, U401.70
MCU_VBUS_EN: R127.1, U301.27
PCPWR_A: D104.2, JP102.2
PC_CC1: J401.A5, R401.1, U107.4
PC_CC2: J401.B5, R402.1, U107.5
PC_USB_DN: J401.A7, J401.B7, U401.22, U402.3, U402.4
PC_USB_DP: J401.A6, J401.B6, U401.23, U402.1, U402.6
PC_VBUS: C404.1, D401.1, J401.A4, J401.A9, J401.B4, J401.B9, JP102.1, R403.1
PC_VBUS_DET: C405.1, R403.2, R404.1, U401.24
PD_CC1: J101.A5, R104.1, R106.1, U107.1
PD_CC2: J101.B5, R105.1, R107.1, U107.2
PD_PG: R108.1, U101.10, U301.33
PHONE_CC1: J201.A5, R211.1, R304.1, U201.14, U204.1
PHONE_CC2: J201.B5, R212.1, R305.1, U201.15, U204.2
PHONE_ISENSE: C130.1, U106.1, U301.17
PHONE_SBU1: C216.1, J201.A8, U204.4
PHONE_SBU2: C217.1, J201.B8, U204.5
PHONE_USB_DN: J201.A7, J201.B7, U205.3, U205.4, U301.58
PHONE_USB_DP: J201.A6, J201.B6, U205.1, U205.6, U301.59
PHONE_VBUS: C219.1, C220.1, D201.1, J201.A4, J201.A9, J201.B4, J201.B9, R126.2, R210.1, R306.1, TP506.1, U106.4
PHONE_VBUS_EN: Q103.1, R125.1, R127.2, R128.2
PHONE_VBUS_SENSE: C314.1, R306.2, R307.1, U301.16
PSW_G: C128.2, D102.2, Q101.4, Q102.4, R123.2, R124.1
PSW_GD: Q103.3, R124.2
PSW_IN: JP101.2, Q101.5, Q101.6, Q101.7, Q101.8
PSW_OUT: Q102.5, Q102.6, Q102.7, Q102.8, R126.1, U106.3
PSW_S: C128.1, D102.1, Q101.1, Q101.2, Q101.3, Q102.1, Q102.2, Q102.3, R123.1
RECOVERY_KEY: R412.2, SW501.1
SOC_CON_RX: J503.3, U401.73
SOC_CON_TX: J503.2, U401.72
SOC_LT_RST: R213.1, U401.61
SOC_MCU_RST: R413.1, U401.90
SOC_NPOR: SW502.1, U401.74
SOC_RECOVERY: C410.1, R411.1, R412.1, U401.26
SPI_CS: U301.20, U401.101
SPI_MISO: U301.22, U401.98
SPI_MOSI: U301.23, U401.99
SPI_SCK: U301.21, U401.100
SS_RX1_N: J201.B10, U201.9, U202.5
SS_RX1_P: J201.B11, U201.8, U202.4
SS_RX2_N: J201.A10, U201.3, U203.5
SS_RX2_P: J201.A11, U201.2, U203.4
SS_TX1_N: J201.A3, U201.12, U202.2
SS_TX1_P: J201.A2, U201.11, U202.1
SS_TX2_N: J201.B3, U201.6, U203.2
SS_TX2_P: J201.B2, U201.5, U203.1
SWCLK: J501.3, U301.49
SWDIO: J501.2, U301.46
U102_BOOT: C107.1, U102.7
U102_EN: R111.2, R112.1, U102.3
U102_FB: R109.2, R110.1, U102.5
U102_SW: C107.2, L101.1, U102.8
U102_VCC: C106.1, U102.6
U103_BOOT: C115.1, U103.7
U103_EN: R115.2, R116.1, U103.3
U103_FB: R113.2, R114.1, U103.5
U103_SW: C115.2, L102.1, U103.8
U103_VCC: C114.1, U103.6
U104_EN: R117.2, U104.1
U104_FB: R118.2, R119.1, U104.5
U104_SW: L103.1, U104.3
U105_EN: C125.1, R120.2, U105.1
U105_FB: R121.2, R122.1, U105.5
U105_SW: L104.1, U105.3
VBUS_IN: F101.1, J101.A4, J101.A9, J101.B4, J101.B9
VCC_1V8_MOD: R411.2, U401.77
VCC_3V3_MOD: R201.2, R202.2, TP401.1, U401.78
VDDA_MCU: C308.1, C309.1, FB301.2, U301.13
VIN: C101.1, C103.1, C104.1, C105.1, C111.1, C112.1, C113.1, D101.1, F101.2, JP101.3, R101.1, R111.1, R115.1, R409.1, TP501.1, U102.2, U103.2
VIN_SENSE: C409.1, R409.2, R410.1, U401.27
