pravrilgreen/iphone-hid/(commit log)

2026-09-24 Initial scaffold: project layout, handoff doc, CH9329 frame codec
    Claude-Session: https://claude.ai/code/session_01QdSfAbTvy9fpZqxa3FxVuw
2026-09-24 Add CH9329 driver, simulated chip, baud scanner and hidtest CLI; rewrite README
    - protocol: checked against the WCH CH9329 serial protocol V1.0; add media/ACPI,
    absolute mouse, LEN bound and garbage accounting in the parser
    - config: 50-byte parameter block with safe write rules and backups
    - ch9329: pyserial driver with ack and fire-and-forget modes, stale-ack handling,
    explicit timeouts and operator-facing error messages
    - fake: byte-level chip emulator on a pty with simulated pointer and keyboard
    - scan: find port, baud rate and address without writing config
    - tools/hidtest.py: interactive and scripted hardware test CLI with JSONL logs
    - README: product vision, API/SDK mock, architec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
2026-09-24 Test the HID layer end to end on the simulated chip; fix two driver bugs
    - Reply loop dropped frames returned by its blocking poll, so a reply that
    arrived in one piece could time out; covered by a deterministic regression test
    - sync() now keeps waiting while fire-and-forget acks are still arriving
    - Config backups no longer collide when written twice in the same second
    - Tests use the example frames from the WCH protocol document as golden vectors
    Claude-Session: https://claude.ai/code/session_01EUDgAy5nU6wYzfaiaKBwjy
2026-09-24 Pointer control without vision, device layer, simulator and video capture
    - Pointer: anchored open-loop moves (nearest corner, per-axis runs from rest at a
    fixed report rate) with per-direction run models; absolute positioning when the
    phone follows absolute reports; pipelined runs whose acks are all verified,
    pacing checks and redo-from-anchor so no report is silently lost or mistimed
    - Calibration through a web page opened in Safari on the phone: detects absolute
    support, otherwise measures run models, edge offsets and reset length
    - IPhoneDevice: serialized actions, health monitor, live relative/absolute and
    keyboard input for remote control, screenshots cropped by geometry
    - Si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
2026-09-24 Hardware test tools and docs for the vision-free design
    - tools/hid_loopback.py: read back what the chip delivers over USB (evdev, grabbed)
    to catch lost, merged or late reports before an iPhone is involved
    - tools/capture_check.py: capture card formats, real fps, passthrough, bandwidth,
    several cards at once
    - Open V4L2 devices by index resolved from by-path links (some OpenCV builds
    cannot open them by name)
    - README rewritten as an end-to-end description; architecture, simulator,
    getting started and the phase 0 checklist follow the risk-ordered test plan
    Claude-Session: https://claude.ai/code/session_01EUDgAy5nU6wYzfaiaKBwjy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
2026-09-24 Calibration picks coarse and fine report sizes per phone
    A coarse report now moves about 20 pt and a fine one about 1 pt whatever the
    Tracking Speed: on the simulator every configuration (3 models x Tracking 0.4-2.5)
    taps within 1 pt, 1.2-1.5 s median per tap, with no calibration click off the page.
    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
2026-09-24 WIP: API server and ESP32 firmware in progress (not yet reviewed)
    Snapshot of work still being written, kept on the feature branch only.
    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
    [partitions.csv]
2026-09-24 Plug-and-play box: zero-config rig discovery, hot-plug, mDNS, deploy files
    - ihc.rigs + registry.auto(): probe USB serial ports for CH9329-protocol chips
    (baud found automatically), list capture nodes, pair them by USB hub, stable ids
    from the physical port, per-rig calibration in a state dir; rescan picks up
    rigs plugged in later without touching ports or cards already in use
    - ihc.discovery: announce the box as _ihc._tcp over mDNS and browse for boxes
    - deploy/: systemd unit, udev rules (permissions, no ModemManager probing, no USB
    autosuspend) and an install script for a dedicated host
    - Calibration exposes the coarse travel target; relative-mode timing limits
    documented; the 'v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
2026-09-24 Faster anchoring, precise chip errors from runs, README illustrations
    - Corner slams go out unpaced (only the line limits them) with every ack still
    verified; median tap time on the simulator is now 1.2-1.5 s across models and
    Tracking Speeds, max error under 0.9 pt
    - A chip error inside a pipelined run (e.g. EXEC_ERROR while the phone is locked)
    is raised as that error instead of a retried desync
    - The deterministic simulator charges the wire time of each frame
    - tools/make_readme_images.py renders the README figures from the real code:
    simulated screens, the pointer path in both modes, the calibration page, and
    the accuracy/time chart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
2026-09-24 ESP32 bridge firmware: BLE or USB output, absolute pointer, on-chip timed runs
    Speaks the CH9329 serial protocol so the host driver works unchanged. Replies 00 only
    once the phone accepted the report (BLE notification queued for a subscribed, encrypted
    link; USB transfer completed), E6 otherwise. Adds an absolute pointer report, a
    keyboard-only profile, GET_INFO version 0x40 with output/collection/feature bytes and
    the vendor command 0x30 (relative reports timed on the bridge).
    Host tests: 70 unit tests under ASan/UBSan and a pty end-to-end run of the Python
    driver against the C core. Both variants build with ESP-IDF v5.4; not yet flashed.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
2026-09-24 Never mistake a late ack, never leave a button held, bridge-timed pointer runs
    Review fixes:
    - driver: after a timeout or a lost ack the next exchange first sends GET_INFO and discards
    every reply before its answer, so a late ack is never counted for a later command;
    release_all also releases media and power keys
    - keyboard: a failed final release is raised instead of swallowed; type() records progress
    - pointer: a failed button report is released (on both the relative and the absolute
    report) before the next anchor instead of locking the device out; click releases even
    when the press failed; pace tolerance 1.5 ms, checked on send and on write completion;
    anchor bursts keep a line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
2026-09-24 Pace pointer runs at a multiple of the link's report period
    Over Bluetooth the phone takes reports at connection events. At a 20 ms pace over a
    15 ms link the spacing iOS sees alternates 15/30 ms and the simulated taps miss by up to
    30 pt; at 30 ms they land within 1 pt. The bridge reports its link period in GET_INFO
    bytes 6-7 (0.25 ms units), calibration picks the smallest multiple of it that is at
    least 20 ms, and the health check asks for a recalibration if the link renegotiates.
    The simulated bridge now holds each report until the next link event. The hardware
    checklist records the report spacing the host actually receives (T0).
    C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
2026-09-24 One schedule per host-timed run; timing illustration
    A late report no longer pushes the rest of its run back: the next report goes out on its
    own slot, so a small delay stretches one gap and shortens the next and the distance error
    cancels to first order. The pace check measures each report against its slot. With the
    simulated busy host of the new timing figure (0.2 ms sleep overshoot, 1% stalls) the worst
    tap error drops from 3.8 pt to 1.25 pt; up to five attempts per move absorb the stalls.
    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
2026-09-24 Bridge reports its link period in GET_INFO bytes 6-7
    u16 little-endian in 0.25 ms units, 0 when unknown: the BLE connection interval (read on
    connect and on connection updates) or the USB polling interval while mounted. The host
    paces pointer runs at a multiple of it. Unit tests (72) and the pty end-to-end run of the
    host driver (107 checks) pass; both variants build with 0 warnings.
    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
2026-09-24 HTTP/WebSocket API, Python SDK, ihc CLI and a minimal console
    - REST actions (tap, swipe, scroll, type, key, home, media, open_url, calibrate, scripts)
    validated before anything is sent, run one at a time per phone on its own worker;
    errors are {error, code}: 404, 422, 409, 503, 504; typed OpenAPI at /docs
    - video: MJPEG passthrough of the capture card's own JPEG bytes, WebSocket frames for
    grids, newest-frame-only fan-out so a slow viewer never holds anyone back
    - /control WebSocket for live KVM-style input: moves coalesced to one report per 16 ms
    with exact totals, button changes never merged or reordered, release on disconnect
    - Python SDK (Farm, RemoteDevice) and the ihc CLI: ser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
2026-09-24 Drags finish despite pacing drift, fast failure when the chip is gone, SDK discovery
    - a drag cannot be redone while the button is down, so an off-slot report during a drag no
    longer aborts it (it only makes the position unknown until the next anchor)
    - after a failed action the device first checks the chip answers at all; if not, releases
    are deferred to the health monitor instead of each waiting for its own timeout
    - the simulated capture shows a cut HDMI signal on the very next frame
    - Farm.discover() finds every box announcing itself over mDNS; `ihc devices` uses it by
    default; `ihc serve --sim-bridge` simulates the ESP32 bridge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
2026-09-24 WIP: calibration safety fixes in progress (not yet reviewed)
    Snapshot of the calibration agent's working tree: bounded page entry, stale click
    events dropped by sequence number, geometric approach runs, absolute map fitting and
    an acceptance threshold. Not merged to main until reviewed and tested.
    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
2026-09-24 Calibration never clicks blindly; the simulated pointer ignores Python thread delays
    Calibration (review C1, C2, M8, M9):
    - every page event carries seq and t, and the page repeats hello as a heartbeat: an event
    stamped after a click that arrives without the click proves a miss; a seq gap (lost
    events) or a late answer stops calibration instead of clicking on
    - looking for the page is bounded (the page top is never below 20% of the screen) and
    steps are sized so even the fastest report stays above the floor; with hover events no
    click misses at all
    - runs grow 1, 2, 4... reports and are sent only if their worst case stays 6% inside the
    page; the report size halves if a single repor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
2026-09-24 Refresh README figures and numbers after the calibration fixes
    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
2026-09-24 README diagrams as images: GitHub's mobile app shows Mermaid as source
    The four diagrams (overview, USB-C and Lightning wiring, acknowledgement flow) are now
    PNGs drawn by tools/make_diagrams.py, laid out for a phone-width screen.
    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
2026-09-24 API: calibration may force relative mode and set the acceptance threshold
    try_absolute, max_error and coarse_target join the accepted calibration options, so a
    hardware test can compare both pointer modes on the same phone.
    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
2026-09-24 Calibrate a page opened by hand (open_page=false)
    When Cmd+Space does not open Spotlight on a phone, the operator types the calibration
    URL in Safari and calibrates with open_page=false; no keystroke is sent.
    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
2026-09-24 Docs: console names, hand-opened calibration, Safari address bar at the bottom
    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
2026-09-24 Nothing stays held, calibration keeps its pace on failure, absolute settle measured
    Second review, core fixes:
    - releases are states, so an undelivered one (E6: full Bluetooth buffers) is retried;
    release_all reports what could not be released and the health monitor keeps trying
    - the first health check that finds the phone taking input (start, reconnect, unlock,
    reopened port) releases everything; a port error marks a release as pending
    - a failed calibration restores the installed model with its pace; a Bluetooth bridge
    without a link refuses to calibrate; a link whose period no longer divides the pace
    puts the device in the new state needs_calibration
    - the bridge probe is asked a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
2026-09-24 Research: absolute pointer on iPhone, cheap Chinese control hardware
    Two research reports (docs/research): an iPhone follows a USB absolute mouse on iOS 26
    (two independent projects, AssistiveTouch on), Bluetooth likely too, digitizers are a dead
    end; the market's no-jailbreak products all drive AssistiveTouch with HID like this
    project, with AirPlay video in the Chinese farm boxes.
    The hardware checklist gains the CH9329 descriptor dump, a four-configuration T1 matrix
    (including the ESP32 absolute-only reference), a Caps Lock LED round trip (hidtest
    capscheck) as proof that iOS processed a key, Full Keyboard Access chords, Bluetooth
    absolute first, a wired Lightning option with AirPlay vid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
2026-09-24 WIP: API security and firmware timing fixes in progress (not yet reviewed)
    Snapshot of two agents' working trees: token auth, Origin/Host checks and request
    lifecycle in ihc/api; quarter-millisecond runs, late-run status, USB completion matching
    and descriptor changes in the ESP32 firmware. Not merged to main until reviewed and tested.
    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
2026-09-24 Bridge firmware: exact run pace, late-run status, descriptors per research
    - SEND_MS_REL_RUN flag bit 7: interval in 0.25 ms units (22.5 ms for an 11.25 ms link);
    runs timed on a microsecond clock
    - new status 0xE7: every report delivered but one went out off its slot (more than 2 ms
    late at the link), so the host redoes the move instead of trusting the landing
    - USB: each report waits for its own completion (a late completion is no longer credited
    to the next report)
    - Bluetooth maps with a single collection carry no Report ID (an iOS quirk); the absolute
    report never starts at (0,0); names and serials carry the descriptor variant so iOS does
    not reuse a cached descriptor; USB int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
2026-09-24 Host side of exact bridge runs: 0.25 ms pace, runs played late are redone
    - runs are sent with a 0.25 ms interval when the bridge advertises it (an 11.25 ms
    Bluetooth link is paced at exactly 22.5 ms); with older firmware calibration picks a
    pace that is a whole number of ms and still a multiple of the link period (45 ms)
    - status 0xE7 (run played off schedule) redoes the move from a corner, like a late report
    with host timing
    - the simulated bridge speaks the same protocol (quarter-ms flag, late status, a way to
    hold the link up) and the firmware end-to-end test drives a 22.5 ms run through the C core
    Claude-Session: https://c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
2026-09-24 API access control, Python 3.10 fix, request lifecycle; calibration page key
    Second review, API layer:
    - a token guards every API call (install.sh creates one; --token/--token-file/IHC_TOKEN;
    the SDK, CLI and console send it); Host names are checked against DNS rebinding;
    browser Origins must match; every action POST must be JSON (no cross-site forms);
    bodies are capped; one live-control session per device (takeover on request);
    viewer and WebSocket limits; calibration options validated before the phone is touched
    - the calibration page carries a one-time key in its link and sends it with its events;
    the key rotates when a calibration ends, and an expired page says so and goes quie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
2026-09-25 Linux USB gadget HID backend and HDMI-input video over a JPEG pipe
    The box itself can now be the phone's keyboard and mouse: ihc.hid.gadget
    sets up the kernel HID function through configfs (keyboard, consumer,
    system, relative mouse, absolute pointer, each its own interface) and
    GadgetBackend speaks the CH9329 backend API over /dev/hidg*. A report
    counts as delivered once the phone has polled it (POLLOUT after write),
    a stuck report is a timeout counted once, and a disconnect that
    completes a transfer is not taken for a delivery.
    tools/gadget.py up/down/status; hidtest --gadget runs the same checks.
    ihc.video.pipe reads JPEG frames from a command's stdout (GStreamer
    mppjpegenc, jpegenc or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
2026-09-25 All-in-one box: serve the board's own USB gadget and HDMI input
    ihc serve --auto now finds the configfs gadget as the rig "iphone" and
    pairs it with the board's HDMI input (rk_hdmirx / snps_hdmirx), read
    through a JPEG-encoding GStreamer pipeline (hardware mppjpegenc when the
    image has it). The input advertises a 1080p60 EDID so the phone mirrors
    at 1920x1080. Without a gadget, a CH9329 cable on the board pairs with
    the HDMI input instead. Farm configs take hid = { gadget = ... } and
    video = { input = "hdmi" } or { command = ... }.
    ihc gadget up/down/status (tools/gadget.py wraps it); deploy installs
    ihc-gadget.service to set the gadget up at boot on boards with a USB
    device controller, a u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
2026-09-25 README and diagrams: the Orange Pi 5 Plus all-in-one box, USB-C iPhones only
    The README now describes one board per iPhone: the board's USB-C port
    is the phone's keyboard and mouse, its HDMI input the video, with a
    CH9329 cable as the fallback. Lightning and the ESP32 bridge are gone.
    New overview, wiring and reliability diagrams; the timing figure keeps
    only the host-timed pace check.
    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
2026-09-25 HDMI input: let videoconvert adapt the receiver's format for the hardware encoder
    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
2026-09-25 Drop the ESP32 bridge and Lightning phones; CH9329 and USB gadget only
    The product now supports two HID devices: the CH9329 serial chip and the
    Linux USB gadget backend (the box itself is the phone's keyboard and mouse).
    Only iPhones with a USB-C port are supported.
    - firmware/esp32_ble_hid is gone.
    - protocol: no bridge version/outputs/collections/feature flags, no
    SEND_MS_REL_RUN (0x30) or RUN_LATE (0xE7).
    - CH9329 driver: GET_INFO parses the chip fields only; no chip-timed runs,
    capability probes or report period.
    - FakeChip, DirectHid, make_rig, direct_phone, `ihc serve`: no bridge
    options (--sim-bridge removed).
    - PointerModel: host-timed runs only (no onchip_runs); pace_interval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
    [partitions.csv]
2026-09-25 Docs: the Orange Pi 5 Plus box is the product; drop ESP32 and Lightning
    Rewrite the Vietnamese docs and the two research reports for the final
    scope: USB-C iPhones only (15 and later, not 16e/17e), one Orange Pi 5
    Plus per phone whose Type-C port is the phone's keyboard and mouse
    (Linux USB gadget) and whose HDMI input takes the video, with a CH9329
    cable as the fallback.
    - architecture: the box first, gadget and CH9329 backends behind one API,
    HDMI-in JPEG pipeline, delivery levels (polled vs chip ack), one box per
    phone; no bridge, no Bluetooth pacing.
    - phase0-checklist: box tests B1-B8 (UDC, gadget on a laptop, HDMI IN,
    HID on the iPhone incl. abstest/capscheck/trial/Home/profile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
2026-09-25 Name each box's phone after its board; EDID for custom HDMI-input commands
    Every box used to call its phone "iphone", so a farm SDK lookup found
    only the first box's. The gadget rig id is now iphone-<last six
    characters of the SoC serial number> (else the machine id, else the host
    name), or $IHC_PHONE_ID, which ihc.service reads from /etc/default/ihc.
    A video.command on an HDMI input now gets the 1080p60 EDID as well.
    Docs updated for both.
    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
2026-09-25 Self-contained ARM64 box bundle and a release workflow
    tools/build_bundle.sh packs one self-extracting file for the Orange Pi
    5 Plus: python-build-standalone 3.11 for aarch64, the pinned libraries
    as ARM64 wheels (deploy/bundle/requirements.txt, the versions the test
    suite runs with), the app, launchers (ihc, ihc-hidtest,
    ihc-capture-check) and an installer that sets up /opt/ihc, udev rules,
    the API token and both services without pip. tools/check_bundle.sh
    unpacks it and runs its libraries, launchers and a simulated server
    under qemu-aarch64 with an Ubuntu 22.04 user space.
    .github/workflows/release.yml runs the tests, builds and checks the
    bundle and publishes it with SHA256SUMS on every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
2026-09-25 Offline box: read the HDMI input and write its EDID without any system package
    ihc.video.v4l2 reads a V4L2 capture node itself (multi- or single-
    planar, mmap streaming, DV timings for HDMI receivers), converts NV12,
    NV21, NV16, NV24, BGR24/RGB24, YUYV/UYVY (MJPEG passes through) and
    encodes JPEG with the OpenCV the bundle ships, handing back frames
    beyond the requested rate unencoded. It is the last choice after the
    hardware mppjpegenc, GStreamer jpegenc and ffmpeg, so a board with no
    internet and nothing installed still streams. The 1080p60 EDID (EDID
    1.3 + CTA-861 with HDMI VSDB and VCDB, edid-decode conformity PASS) is
    now built here and written with VIDIOC_S_EDID, no v4l-utils.
    The bun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
2026-09-25 Docs: a 10-minute quick test that the iPhone takes the board's mouse
    Unpack the release file, set the gadget up, send relative moves, a click
    and the absolute corners; what each failing step usually means. Linked
    from the README, docs/gadget.md and the release notes.
    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
2026-09-25 Gadget: fit every profile in the kernel's four HID functions
    On the Orange Pi 5 Plus, `ihc gadget up` failed creating the fifth HID
    function (hid.absolute) with ENODEV: f_hid hands out at most four
    minors (HIDG_MINORS) over all gadgets. The system-control interface
    (power/sleep/wake, of no use on an iPhone) is dropped from every
    profile, so RA is keyboard, media keys, relative mouse and absolute
    pointer; A and R have three. Running out of HID functions now says so
    (another gadget may hold some) and still leaves nothing half set up.
    Version 0.1.2.
    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
2026-09-25 Quick test: which way round to cable the hub, and how to tell
    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
2026-09-25 hidtest --gadget is a flag again; quiet tar on boards whose clock is behind
    `ihc-hidtest --gadget "info; move 100 0"` took the command list for the
    gadget name (--gadget had an optional value). It is now a flag, with
    --gadget-name for another configfs gadget. The .run file no longer
    prints a tar warning per file when the board's clock (no network time)
    is behind the build date. The quick test says what to send when the
    gadget stays "not attached". Version 0.1.3.
    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
2026-09-25 Quick test: capture the iPhone's screen through HDMI IN
    - docs/quick-test.md gains the video test: the HDMI wiring (hub HDMI to the board's HDMI IN),
    ihc-capture-check list/snapshot/probe, the live console, and what to do when it fails.
    - ihc-capture-check list reads the HDMI signal straight from the driver when v4l-utils is
    missing (offline boards): resolution, refresh, or why there is no signal.
    - Release notes: the keyboard and mouse have been checked on a real board. Version 0.1.4.
    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
2026-09-25 Gadget profile AR; say why a board shows no HDMI input
    - Profile AR: keyboard, media keys, absolute pointer, then relative mouse (JetKVM's interface
    order), to try on an iPhone that ignores the absolute pointer in RA. gadget_functions follows
    the profile's order, read back from the serial number.
    - ihc-capture-check list: with no hdmirx node, print what the board says (device tree node and
    status, bound driver, module files, kernel config, boot overlays) and a verdict.
    - Docs: what to try when abstest does not move the pointer; the HDMI troubleshooting row.
    Version 0.1.5.
    Claude-Session: https://claude.ai/code/session_01EUDgAy5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
2026-09-25 Armbian: turn the HDMI input on with its rk3588-hdmirx overlay
    Armbian's vendor 6.1 kernel builds rk_hdmirx in, but its Orange Pi 5 Plus device tree leaves
    hdmirx_ctrler disabled (detect GPIO, pins and CMA are all there) and ships the rk3588-hdmirx
    overlay that sets it okay. Seen on a real board: no /dev/video*, no hdmirx line in dmesg.
    - The diagnosis names the shipped overlay and the boot file to add it to; the always-on
    hdmiin-sound node no longer counts as the receiver.
    - ihc-capture-check waits up to 15 s for the first frame: the new EDID makes the source replug.
    - Docs: enabling the overlay (gadget.md, quick-test.md). Version 0.1.6.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
2026-09-25 Console: choose the absolute pointer without calibrating
    An iPhone 15 on the box follows the absolute pointer (abstest reaches the corners), but the
    server only used absolute mode after a Safari calibration, which needs the phone on the
    host's network.
    - IPhoneDevice.set_pointer_mode("absolute" | "relative"), kept in the calibration file: the
    whole report range over the whole screen until a calibration measures the map.
    - POST /api/devices/{id}/pointer and Device.set_pointer_mode in the SDK.
    - ihc serve --pointer (default $IHC_POINTER): the mode of a phone with no calibration file
    yet, rigs plugged in later included; a saved choice or a calibration wins.
    - Console: Absolute / Relative u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
2026-09-25 Diagnosis: say how this board's boot script takes the HDMI input overlay
    On a real Orange Pi 5 Plus with Armbian, rk3588-hdmirx added to overlays= left the HDMI input
    disabled. Armbian boot scripts older than 24.11 load an overlays= entry only as
    <overlay_prefix>-<entry>.dtbo, so with overlay_prefix=rockchip-rk3588 the kernel's
    rk3588-hdmirx.dtbo is skipped without a word (and so are other rk3588-* entries).
    - The verdict reads /boot/boot.cmd and the boot environment: the overlays= entry to add (with
    the prefix taken off when it fits), user_overlays with the copy commands when overlays= cannot
    name the file, "reboot" when the environment changed after this boot, and a note when a listed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
2026-09-25 Docs: which Orange Pi 5 boards can be the all-in-one box
    From the vendor 6.1 and mainline device trees and the published specifications: only the 5 Plus
    has both a Type-C port that becomes a device with a standard cable (FUSB302, USB role switch) and
    an HDMI input. The 5 Ultra has the HDMI input (enabled by default) but its Type-C is power only;
    the 5 Max has neither (two HDMI outputs, OTG controller fixed to host). Both work with a CH9329
    cable, plus a USB capture card on the Max.
    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
2026-09-25 Custom box design: block diagrams
    tools/make_box_diagrams.py draws, in the README diagrams' style, the two box variants under
    study: a standalone box (USB-C to the iPhone carrying DP Alt Mode video, USB 2.0 HID and 5 V
    charging; DP to CSI-2 bridge, HID MCU, SoC with a hardware encoder, Ethernet, Wi-Fi, USB to a
    PC, optional HDMI out) and a dock for a PC (Type-C to HDMI converter, HDMI to UVC capture,
    HID MCU, USB hub). The write-up follows in docs/research/custom-box.md.
    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
2026-09-25 Research: a purpose-built box, and whether the CH9329 is fast enough
    docs/research/custom-box.md (Vietnamese), from three research passes over datasheets, open
    KVM projects (JetKVM, NanoKVM, PiKVM, PicoKVM, Comet, Aiden: architecture only, no code taken)
    and Linux drivers:
    - Time budget: a tap is 150-350 ms, mostly the iOS pointer glide; the HID chip saves 1-10 ms.
    Video decides what the user sees: H.264 low-delay over WebRTC 35-60 ms (PiKVM, JetKVM).
    - CH9329: fixed descriptors, chip-level ack, 115200 baud; replace with a CH32V305RBT6 (HS with
    PHY + a second FS port, LQFP64, ~$1.33) running timed tap/swipe/type on its own timer.
    CH9329F as a quick drop-in (HS, fast UART, fixed descri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
2026-09-25 Research: the shopping list for the custom box, one pick per item
    docs/research/custom-box.md section 13. First batch (now): two WCH CH32V307V-EVT-R1 (HS + FS
    USB on Type-C, WCH-LinkE on board, same USB block as the CH32V305), a Cynthion USB 2.0 HS
    analyzer, a JetKVM as the ready RV1106 + TC358743 platform (developer mode, open build),
    an LT7911D evaluation board with CSI firmware from a Lontium agent (the rockchip lt7911d
    driver loads no firmware; retail VR boards ship DSI firmware; the Armbian vendor kernel on the
    Orange Pi already has the driver), a POWER-Z KM003C PD logger, a DSLogic Plus, and a
    Thunderbolt 4 cable (the iPhone's own cable has no DP lanes). Soldering tools, and a second
    b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
2026-09-25 Sleeping iPhone: declare USB remote wakeup, add `ihc gadget wake`
    A phone left idle locks and sleeps; it then stops polling the HID interfaces, so every report
    times out. Research and tooling:
    - The gadget's configuration declares remote wakeup (bmAttributes 0xa0; remote_wakeup=False
    keeps 0x80). udc_wakeup() writes "1" to /sys/class/udc/<udc>/srp, which calls
    usb_gadget_wakeup(); Rockchip's 6.1 DWC3 signals it when the link is suspended.
    wake_host() then waits for the host to use the bus again.
    - `ihc gadget wake`, hidtest `wake`, GadgetBackend.wake(); a udev rule lets group ihc write
    srp, so the service needs no root for it.
    - Docs: Auto-Lock Never is mandatory (Low Power Mode for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
2026-09-26 box: HDMI capture, JPEG, simulated iPhone
    - internal/video: V4L2 capture (multi-planar and single-planar, DV
    timings, EDID 1080p60), the phone screen cropped out of each frame
    with video-range levels expanded, JPEG by libjpeg-turbo (turbojpeg
    build tag, 3 ms for a 498x1080 screen) or image/jpeg, a frame hub that
    encodes each frame once per quality and restarts the source
    - internal/sim: a simulated iPhone behind the same HID and video
    interfaces (home screen pages, scrolling with momentum, Notes,
    Search, app switcher, volume HUD)
    - input stats over a sliding two-second window
    Claude-Session: https://claude.ai/code/session_0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
2026-09-26 box: API server, live control protocol, ihcd command
    - internal/server: REST actions (tap, long press, swipe, drag, scroll,
    type, key, phone buttons, media keys, open URL, wake), status,
    screenshot (JPEG or PNG), MJPEG, a screen stream WebSocket with
    per-frame acks, a live control WebSocket with a compact binary touch
    and key protocol and a ping echo, one live controller at a time with
    takeover, OpenAPI document, token auth, host and origin checks, mDNS
    - internal/board: device id from the board serial, video nodes, why an
    HDMI input is missing (device tree, driver, Armbian overlays)
    - internal/hid: a sink that opens the gadget when it appears
    - cmd/ihcd: serve (hardware or --sim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
2026-09-26 box: new web console
    One phone on a bench mat, drawn as the device: the live screen inside a
    titanium frame, volume keys and the side button (wake) where they are on
    the phone, Home, App Switcher and Search under it.
    - touch streams at the browser's event rate as 7-byte binary messages
    (raw pointer updates where the browser has them); a press or release
    is never dropped, moves are skipped only while the link is backed up
    - drag, swipe and the wheel act live; the keyboard goes to the phone
    while the screen is focused, Cmd/Ctrl+V types the clipboard
    - touch latency, picture rate and age, round trip in the top bar
    - Type, Keys, Media, Screen (orientation, screenshot) and Connection
    pan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
2026-09-26 Python is the SDK; the box ships as one static Go binary
    - src/ihc: the SDK only (Farm, Phone, IhcError), mDNS discovery and the
    `ihc` command for test scripts; the Python server, simulator, pointer
    model, calibration, CH9329 backend and lab tools are gone (the box
    does all of that in Go now)
    - tests: the SDK against `ihcd serve --sim`, the box software itself,
    checking what the simulated phone shows (/api/devices/{id}/sim)
    - packaging: ihcd.service, ihcd-gadget.service, udev rules, installer
    (replaces an earlier Python install), self-extracting bundle header
    - scripts/build_box.sh: static linux/arm64 ihcd with libjpeg-turbo (NEON)
    cross-built with zig cc for musl, bundled into a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
2026-09-26 Docs, README and release notes for the Go box
    - README rewritten around what the box does: live screen, touch as it
    happens with the absolute pointer, keyboard, phone buttons, API and
    SDK; measured performance with where it was measured; install in three
    steps; a console screenshot of the new UI
    - guides: install (parts, wiring, HDMI input overlays, troubleshooting),
    iPhone setup, and a hardware check that tries every touch and button
    on the real phone
    - dev: API reference (REST, stream and live-control protocols, SDK),
    architecture, ADR 0002 (the box software is Go on every box)
    - the superseded guides, simulator and CH9329 notes, feasibility study,
    test checklist and old imag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
2026-09-26 Report starting until the first picture; SDK tests wait for a ready box
    A freshly started box said no_video before its first frame, which the
    SDK tests caught on a slower CI runner.
    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
2026-09-26 hardware/box-v1: schematic of the purpose-built box
    Pin-level design of the standalone box: USB-C PD input (CH224K, 9 V),
    buck converters for the phone's 5.2 V and the system rails, the iPhone's
    USB-C into an LT7911D (DP Alt Mode to 4-lane MIPI CSI-2), a CH32V305RBT6
    as the USB High-Speed HID device, a Luckfox Core1106 (RV1106G3) with
    100M Ethernet and USB-C to a PC, debug headers, LEDs and buttons.
    - netlist.py is the single source: parts, LCSC numbers, footprints,
    every pin with its source and confidence
    - generate.py writes the KiCad 8 project (5 sheets), SVG sheets, BOM,
    JSON and KiCad netlists, and the pin tables of the design document
    - check.py: every pin connected or marked no-c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
    [bom.csv, box-v1.kicad_sch, debug.kicad_sch, iphone.kicad_sch, mcu.kicad_sch, power.kicad_sch, soc.kicad_sch]
2026-09-26 Bundle build: works with CMake 4, libjpeg-turbo 3.1.2
    CMake 4 passes -Wl,-v and -Wl,--dependency-file to the linker, which
    zig's linker refuses: its compiler checks failed and libjpeg-turbo took
    the target for 32-bit ARM. The zig-cc wrapper leaves both out, and only
    the static library is built (nothing to link).
    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
2026-09-26 Console: clearer typing indicator; touch stats leave out the settle
    - The touch latency no longer counts the deliberate 80 ms wait before a
    press that follows a jump: the stats measure the box.
    - While the keyboard goes to the phone, the device is outlined and
    labelled "Keyboard to phone".
    - The takeover banner and the toast size to their text on narrow screens.
    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
2026-09-26 Simulated faults; the console shows a lost box and a lost picture
    - With --sim, POST /api/devices/{id}/sim {"usb": "unplugged"|"asleep"|
    "connected", "video": "no_signal"|"ok"} makes the simulated phone's
    cables report a fault, through the same paths as the hardware: the
    status, 503 no_usb / asleep on actions, Wake, no_video.
    - Console: when the box stops answering, the state reads "Box
    unreachable" instead of keeping the last one; without a picture the
    last frame is greyed under the note instead of looking live.
    - Console: hover and touches on an unplugged or sleeping phone no longer
    raise an error toast each time (the state line says why); clicked
    buttons still do.
    - Console: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
2026-09-26 ihcd doctor; research in English; demo videos in the repo
    - `ihcd doctor` examines the board and the box part by part: the
    kernel's gadget framework and HID function, the USB device port
    (dr_mode, role switches), other gadgets holding the controller, the
    gadget, its nodes, the iPhone's link, the HDMI input and its signal,
    the services, the API and the token. Each problem comes with a fix or
    advice. --fix applies the run-time fixes; --fix-boot also adds the
    HDMI receiver's overlay to the boot environment, keeping a backup.
    --json for scripts. `ihcd check` runs it too; the installer runs
    `ihcd doctor --fix` at the end.
    - docs/research/custom-box.md is in English and matches the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
2026-09-26 Never send the pointer to the corner; research docs match the box
    - Touch engine: a release or a button press while the box does not know
    where the phone's pointer is (after a start or an error) used the zero
    position, so the first key, button or click action after a restart
    moved the pointer to the top left corner and pressed there. It now
    uses the centre of the screen, and settles there before a press.
    - docs/research/absolute-pointer.md and china-market.md describe the
    current box (absolute pointer only, ihcd, ihcd hid and doctor checks)
    instead of the removed CH9329 fallback, calibration and test tools.
    - iPhone setup: keep Dwell and Zoom off.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
2026-09-26 hardware/box-v1: English translation in progress
    A snapshot of netlist.py and generate.py while they are being translated
    and the BOM completed; the generated files follow in the next commit.
    Also ignore *.pid files left by local test servers.
    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
2026-09-26 HTTPS, security and status in the docs; a resting finger does not fling
    - ihcd serve --tls-cert/--tls-key serves HTTPS; mDNS announces the
    scheme and Farm.discover() uses it.
    - README: what was verified on a real iPhone and what only against the
    simulated one, the limits, a security section, where each performance
    figure comes from, iPhone Air among the phones without video output,
    the SDK installed from git (it is not on PyPI).
    - Install guide: a shared token for a farm, every serve flag, a network
    and security section, going back to an older version. SECURITY.md.
    - Simulated phone: a finger that rested 100 ms before lifting flings
    nothing, as on iOS; drag's rest made the SDK te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
2026-09-26 Touch engine: presses and releases stay where they were made
    - A live move merged into the queued touch at the tail even when that
    was a press or a release: behind a slow report, a press went out where
    the drag ended (a tap instead of a drag) and a release where the next
    hover went (a drag instead of a tap). Moves now merge only into moves.
    - Every hover move within the settle of a jump counted as a new jump, so
    a hovering mouse kept delaying its clicks by up to 80 ms. Only a real
    jump starts a glide; a press waits only while one is running.
    - A script starts with the operator's finger and keys lifted, so a tap
    made while someone holds the screen stays a tap.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
2026-09-26 hardware/box-v1 in English, with an order package
    - Everything in hardware/box-v1 is English: netlist.py, the generators,
    the checks, the README, and the regenerated KiCad sheets, SVGs, BOM
    and netlists. Labels are Confirmed / Likely / Unknown; Option A/B.
    - netlist.py carries the ordering data of every BOM line: manufacturer,
    MPN, LCSC code with its evidence, JLCPCB class, price estimate, how it
    is assembled. bom.csv has the new columns; check.py rule R11 checks
    them and the selftest plants 12 faults.
    - ORDERING.md: what to send a layout and assembly house, what is done
    and what the vendor does (the layout), the LT7911D documents to ask
    Lontium for, fabrication and assembly sp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
    [bom.csv, box-v1.kicad_sch, debug.kicad_sch, iphone.kicad_sch, mcu.kicad_sch, power.kicad_sch, soc.kicad_sch]
2026-09-26 API: actions in order, strict parameters, liveness, clear errors
    - Control socket: a connection's actions run one after the other in the
    order sent (they ran in parallel goroutines, so eight typed letters
    came out shuffled), end when the connection ends, and at most 64 wait.
    The box pings every 2 s and drops a client silent for 6 s, so a laptop
    that slept no longer holds the phone and its pressed finger.
    - Each action takes only its own fields; a misplaced one (duration_ms on
    a tap), trailing data after the JSON body, or a wrong type is a 400
    with a plain message. The socket checks the same way and its results
    carry a code.
    - An action's time limit is a minute plus what it last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
2026-09-26 Gadget set up again, frame waiters, EDID retry, status fields
    - The USB sink leaves nodes that no longer belong to the gadget (it was
    set up again: new nodes, or the same names made anew) and opens the
    current ones; before, input failed until ihcd was restarted.
    - A cancelled wait for a frame no longer leaves its waiter behind (every
    screenshot without a picture leaked one).
    - The EDID is written before each capture start until it succeeds, and
    the source says when it could not be written; a source may find its
    node again before each start.
    - The status always has message and last_action (null before any).
    Claude-Session: htt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
2026-09-26 SDK and ihc: retryable errors, wait_ready, media keys, IHC_URL
    - IhcError.code is unreachable or timeout when the box does not answer,
    and retryable says whether the same call may work later; the module
    help lists every code.
    - Phone.wait_ready(), media(), volume_up/down, mute, play_pause,
    set_landscape().
    - ihc: $IHC_URL, options before or after the command, a screenshot to a
    missing directory is an error message, not a traceback; exit 3 when
    no box can be reached; the 401 hint names --token.
    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
2026-09-26 Console: the operator lock holds, plain words, key names
    - A console that another operator displaced sent its panel's buttons,
    typing and keys over REST anyway; it now says to take over first. When
    the other operator leaves, it takes control back by itself.
    - When the box stops answering, the meters and Connection lines are
    cleared instead of showing the last values; actions say the box is
    unreachable. A token changed on the box is asked for again (a refused
    WebSocket shows up as an abnormal close).
    - Frames that arrive out of order are skipped; acks name their frame.
    - Keys released while Cmd is held are let go with Cmd (macOS sends no
    keyup for them), so the phone does not see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
2026-09-26 doctor and gadget set-up: review fixes in progress
    A snapshot of the doctor, board and gadget changes being made from the
    embedded Linux review (fix classes, Type-C state, legacy gadgets, safer
    --fix-boot); it builds and its tests pass. The packaging and guide
    changes follow.
    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
2026-09-26 board: tests for the review fixes (in progress)
    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
2026-09-26 Console: icon buttons and an animated set-up and use guide
    - Every button of the console is an icon from its own set (an SVG
    sprite drawn for it: Home, App Switcher, Search, the keys, the media
    keys, orientation, screenshot, send, connect, take over, wake, guide),
    with a tooltip placed over the page and an accessible label.
    - A guide (the button top right, or next to a fault in the state line)
    with four animated drawings: the box now, wiring with a USB-C hub,
    wiring the purpose-built box, and using the console. Cables plug in in
    order, then dots show where the picture, touch and keys, and power
    flow. On "now", the hub drawing takes the box's state: the cable at
    fault blinks,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
2026-09-26 Demo videos: the icon console and the set-up guide
    Recorded with make demo against the simulated iPhone: the guide's tabs
    (this box now, wiring with a hub, the purpose-built box, using the
    console) and the cable at fault when the USB cable is unplugged.
    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
2026-09-26 Packaging, doctor docs and a portable simulated box
    - ihcd-gadget waits for a USB device controller and retries; a controller
    that appears later starts it through udev. The installer starts the gadget
    instead of restarting it (the phone sees no unplug), triggers only the HID
    and video devices, copies LICENSE, and ends with doctor --fix-safe.
    - ihcd serve --max-viewers; --video auto looks for the HDMI receiver again
    on each start, so a receiver that registers late is found.
    - The gadget and the HDMI input are Linux-only files; the simulated box
    builds and runs on macOS, and CI vets that build.
    - CI and make lint run shellcheck on the installer and the scripts; the
    bundle's --help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
2026-09-26 Box v1: second design review and a PCB generator
    - netlist.py: CH224K VBUS pin left open (R102 removed); D101 SMBJ20A clamps
    below the LMR33630's 36 V input; U107 ESD on the rear CC lines; R213 and a
    100 nF C215 on the LT7911D reset; I2C pull-ups on the module's 3.3 V; J201
    HRO TYPE-C-31-M-04 (hybrid, routable B row); TS-1187A buttons; net classes
    shared with the project file and the board.
    - placement.py, pcb.py: the 96x66 mm 4-layer board generated from the
    netlist: footprints (custom LT7911D, Core1106, CH224K, vendored HRO
    receptacle), placement, rules, keep-outs, GND fan-out and stitching,
    Freerouting 1.9 round trip, zones, DRC, compact SVG views.
    - mechanical.py follows pl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
    [bom.csv, debug.kicad_sch, iphone.kicad_sch, mcu.kicad_sch, power.kicad_sch, soc.kicad_sch]
2026-09-26 Box v1 layout: decoupling capacitors face their pins; fixed GND fan-out
    - pcb.py: the radial rotation table put the GND pad of 24 of 29 decoupling
    capacitors towards the IC pin; it now puts the supply pad there (and turns
    a capacitor whose supply is on pad 2).
    - GND fan-out vias and tracks are locked, so Freerouting cannot rip them up;
    an SMD GND pad next to a through-hole GND pad of the same part is joined
    to it on L1 (J201 A1/A12).
    - VBUS_IN and PC_VBUS leave the 16-pin receptacles' 0.6 mm pads at 0.3 mm
    (a 0.8 mm track cannot pass between the 0.5 mm-pitch pads); an L1 pour
    carries VBUS_IN to the fuse.
    - The project file is dropped from KiCad's settings manager after each save,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
    [netlist.py, pcb.py]
2026-09-26 Box v1 layout: 5V_SYS pour during routing; gate nets off the power class
    - The L3 5V_SYS pour exists before routing, so it goes to the router as a
    plane of its net and keeps other nets out of the corridor; its band under
    the module is 2.4 mm tall (it was 0.2 mm and could not carry current).
    - PSW_G and PSW_GD (the VBUS switch's gate drive) are signals, not 3 A
    supplies: only PSW_IN, PSW_S and PSW_OUT keep the 0.8 mm class.
    - GND fan-out vias may sit up to 3 mm from their pad; `--ses` replays make
    the (fixed) fan-out again, since the session file does not carry it.
    Claude-Session: https://claude.ai/code/session_01EUDgAy5nU6wYzfa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
    [netlist.py, pcb.py]
2026-09-26 Box v1 layout: room around the module, GND islands stitched
    - Placement keeps 1.2 mm around the castellated Core1106 free of small
    parts (they sat against its edge pads and left no room for the GND vias
    of pads 25, 28 and 36); R411 gets a hint, and a part whose target lies
    under the module searches further.
    - The J201 A1/A12 links to the through-hole GND pads are 0.25 mm wide: at
    0.3 mm they sat exactly on the clearance and a strict comparison refused
    them.
    - Stitching vias stay out of the 5V_SYS and VBUS_IN pours (pours now exist
    before stitching); after the fill, each GND island without a via gets
    one where it fits.
    Cla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
    [pcb.py, placement.py]
2026-09-26 Box v1 layout: second routing stage, 5V_SYS fan-out
    - Routing runs in two stages: the nets KiCad still finds unconnected after
    the first are routed again at 0.3 mm with every earlier track fixed (the
    enable and sense branches of the supplies could not reach their 0402 pads
    at the supplies' full width). `--ses` takes the sessions of both stages.
    - The fan-out works for any plane net: 5V_SYS pads over the L3 pour get a
    via to it (C401 was left without one). It now also sees the vias and
    tracks already on the board, and its pad-to-pad links respect keep-outs
    (a J201 link crossed the peg hole's keep-out).
    - C209-C211, the decoupling of LT7911D pins without a pad yet, wait beside
    U2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
    [pcb.py, placement.py]
2026-09-26 Box v1 layout: warm-start second stage; narrow fan-out on fine pitch
    - The second routing stage starts from the first one's routing, with the
    open nets in a 0.3 mm class, and may move other tracks: with every track
    fixed it could not route anything and only returned fragments.
    - Session import drops segments shorter than 5 µm (the router's fragments
    at pad edges, reported as dangling tracks).
    - The GND fan-out leaves 0.3 mm pads (LQFP, USON) with a 0.2 mm track, which
    passes between 0.5 mm-pitch neighbours: the MCU's and the ESD arrays' GND
    pins now reach the plane.
    Claude-Session: https://claude.ai/code/session_01EUDgAy5nU6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
    [pcb.py]
2026-09-26 Box v1 layout: second stage keeps the open nets' full-width tracks
    - In the second routing stage the nets left open keep their first-stage
    tracks fixed and only their missing connections go in at 0.3 mm; the
    narrow class keeps the supplies' 0.2 mm clearance. Re-routing a whole net
    narrow had put VIN's 3 A path at 0.3 mm, and at 0.15 mm from other nets.
    - `--ses` replays both stages in the state they were routed in (U201's
    nets stripped).
    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
    [pcb.py]
2026-09-26 Box v1 layout: supply pours with track keep-outs; VBUS_IN pour on L4
    - The supply pours that exist during routing (5V_SYS on L3, and a new
    VBUS_IN pour on L4 under J101 and F101) each sit under a keep-out for
    tracks: the router had run other nets through the 5V_SYS corridor and cut
    the pour into islands.
    - J101's two VBUS pads, which the CC lines separate on L1, and F101 reach
    the VBUS_IN pour through 0.8/0.4 mm vias. GND fan-out vias stay out of
    the supply pours.
    - U103's bootstrap capacitor C115 sits beside the BOOT and SW pins (it had
    landed above the IC), R114 by the FB pin.
    Claude-Session: https://claude.ai/code/sessio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
2026-09-26 Box v1 layout: 5V_SYS pour is the corridor only; R411 by its supply pad
    - The 5V_SYS pour keeps to the corridor between the module and the RJ45
    (down to 40.4 mm): the band along the module's bottom edge took the room
    its GND pads need for vias.
    - R411 (SARADC pull-up) sits at the module's VCC_1V8 pad on the right edge,
    towards the RECOVERY button, not across the module.
    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
2026-09-26 Box v1 layout: keep the second routing stage only when it helps
    After the second stage, KiCad's DRC compares it with the first; its routing
    is kept only with no new error and fewer open connections, otherwise the
    first stage's session is imported again. One run's second stage had left
    overlapping 1V2 and 3V3 fragments.
    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
    [pcb.py]
2026-09-26 Box v1 layout: 5V_SYS pour reaches the module and the U103 route
    - The module's supply pads 79-81 each get a fixed via into the 5V_SYS
    corridor pour (now from 70.0 mm): the router had tied them together but
    to nothing else.
    - After routing, the corridor pour continues below the module, where the
    route from U103's output passes with its vias.
    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
    [pcb.py]
2026-09-26 Box v1 layout: last-mile repair of open connections
    - After the zone fill, each connection KiCad still reports open (outside the
    LT7911D area, not through a pour) gets a straight, L-shaped or 45-degree
    0.25 mm track between its ends when one keeps the clearances and the
    keep-outs.
    - The module's supply pads no longer take vias into the 5V_SYS corridor:
    they crowded the corridor its right-edge signals need.
    - README: `--ses` is a debugging aid (the fixed fan-out is made again and
    must come out as it did for the routing).
    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
    [pcb.py]
2026-09-26 Box v1 layout: 5V_SYS pour gets a foot below the module
    The corridor pour ends in a wider foot below the module, present during
    routing and kept free of other nets' L3 tracks, where the route from U103's
    output arrives. As a post-route pour it was cut off from the corridor by
    three CH224K tracks on L3, leaving the module's supply unjoined.
    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
2026-09-26 Box v1: the draft layout, its DRC report and views
    - kicad/box-v1.kicad_pcb: 96x66 mm, 4 layers, every part placed, routed by
    pcb.py with Freerouting 1.9.0 except the LT7911D area (waiting for its pin
    table) and 8 connections in 7 places listed in README §15. KiCad's DRC
    finds no clearance, hole, edge or keep-out error (kicad/drc.rpt).
    - svg/pcb-*.svg: placement and the four copper layers.
    - README §15 (result table and the open connections), summary, status and
    risk H14; ORDERING.md status, work split and RFQ; CHANGELOG.
    - The DRC report names the board by its path in the repository.
    Claude-Session: https://claude.ai/code/se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
    [box-v1.kicad_pcb]
