pravrilgreen/iphone-hid/(notices)

Notices in the files:
parts and their libraries:
Korean Hroparts TYPE-C-31-M-04 USB-C 24P receptacle, right angle, hybrid: A row SMD, B row through-hole (LCSC C129018). From github.com/jenschr/USB-C-Connectors, public domain (Unlicense), built and tested by its author
